Michielvsb/po2-marsrover/eindverslag.tex

\documentclass[a4paper,10pt]{article}
%\documentclass[dutch]{IEEEtran}
%\documentclass[a4paper,10pt]{scrartcl}
\usepackage{pdfpages} 
\usepackage[dutch]{babel}
\usepackage[utf8]{inputenc}
\usepackage[official]{eurosym}
\usepackage{listings}
%\usepackage{caption}
\usepackage{url}
\usepackage[nottoc, numbib]{tocbibind}
\usepackage{gensymb}
\usepackage{placeins}
\usepackage{float}
%\usepackage[style=ieee, backend=bibtex]{biblatex}
 
\title{Conceptueel schaalmodel van een autonome Marsrover}
\author{Floris Kint \and Selwin Konijn \and Evert Leeuws \and Urban Lemmens \and Jan-Uwe Lorent \and Michiel Vanschoonbeek \and Vincent Vliegen \and Ruben Verhulst}
\date{\today}

\pdfinfo{%
  /Title    (Conceptueel schaalmodel van een autonome Marsrover)
  /Author   (Team 208: Floris Kint, Selwin Konijn, Evert Leeuws, Urban Lemmens, Jan-Uwe Lorent, Michiel Vanschoonbeek, Vincent Vliegen, Ruben Verhulst)
  /Creator  ()
  /Producer ()
  /Subject  ()
  /Keywords ()
}

\begin{document}
\maketitle
\newpage
\input{inhoudstafel.tex}
\newpage
\listoffigures
\newpage
\listoftables
\newpage
\input{inleiding/sec.tex}
\input{conceptkeuze-ontwerp/sec.tex}
\input{experimenten/sec.tex}
\input{demonstratie/sec.tex}
\input{teamprestatie/sec.tex}
\input{discussie/sec.tex}
\input{besluit/sec.tex}
\input{bijlagen/sec.tex}

\bibliographystyle{IEEEtran}
\bibliography{referenties}{}

\end{document}
