Michielvsb/po2-marsrover/conceptkeuze-ontwerp/sec.tex

 
\section{Conceptkeuze en ontwerp}
De lijst met productvereisten hielp bij het vinden van het beste idee. Het ontwerp dat het best voldeed aan de vereisten, een vierwieler met een stuurmechanisme gelijkaardig aan dat van een auto, kreeg verdere uitwerking.
Hierna volgt een besluit over de combinatie van sensoren waarmee de wagen uitgerust is om de omgeving zo goed mogelijk te kunnen aftasten. Rekening houdend met de prijs bleek een afstandssensor, gemonteerd op een servomotor het meest voordelig. Verder is er een elektromotor om de wagen aan te drijven en een servomotor om het stuurmechanisme aan te drijven. 

Een preciezere beschrijving van het mechanisch en elektronisch gedeelte volgt in de volgende paragrafen.

\input{conceptkeuze-ontwerp/materialen/sec.tex}
\input{conceptkeuze-ontwerp/mechanisch/sec.tex}
\input{conceptkeuze-ontwerp/elektronisch/sec.tex}
\input{conceptkeuze-ontwerp/ai/sec.tex}
