Michielvsb/po2-marsrover/conceptkeuze-ontwerp/materialen/sec.tex

\subsection{Materialen}
In het bouwen van de wagen zijn verschillende materialen en onderdelen gebruikt. De belangrijkste zijn hieronder terug te vinden.

De bodemplaat van de wagen is van MDF (hout) en uitgesneden met behulp van een lasercutter. Het sturingsmechanisme is gebouwd uit Lego Technics en de  wielen hebben een doorsnede van 60 mm. Voor de overbrenging zijn er zes tandwielen van 26 mm en twee kleinere tandwielen van 5,2 mm doorsneden.
Een MM28 motor zorgt ervoor dat de wagen kan rijden. 

De wagen verzamelt zijn informatie met behulp van een IR-afstandssensor en een Arduino Uno-controller verwerkt deze informatie dan. Twee servomotors bewegen het sturingsmechanisme en de IR-sensor. Het geheel is verbonden met behulp van kabels die op een Printed Circuit Board gesoldeerd zijn. Een battery pack levert stroom aan de elektrische componenten. 

De volledige materiaallijst is opgenomen in Bijlage~\ref{bijlage:materiaallijst}.
