Michielvsb/po2-marsrover/bijlagen/materiaallijst/sec.tex

\subsection{Materiaallijst}
\label{bijlage:materiaallijst}
\FloatBarrier
\begin{center}
\begin{table}
\begin{tabular}{| p{3cm} | l | p{3cm} | p{2cm} | p{2cm}|}
\hline
& \textbf{Aantal} & \textbf{Component\-nummer / product\-informatie} & 
\textbf{Prijs Per Stuk (\euro)} & \textbf{Totaal (\euro)}\\\hline
\emph{Mechanisch gedeelte} &  &  &  & \\\hline
MDF (hout) & 1 & 60cm*30cm*3mm & 1 & 1\\\hline
Onderdelen Lego* &  & Geschatte kostprijs: \euro15 & 0 & 0\\\hline
Duct Tape &  &  & 0 & 0\\\hline
Schroefogen & 9 &  & 0.12 & 1.08\\\hline
Bouwpakket & 2 &  & 2.6 & 5.2\\\hline
Tandwiel 50/10 & 10 & 841027 & 0.1 & 1\\\hline
Tandwiel 30/10 & 10 & 841016 & 0.085 & 0.85\\\hline
Zeskantmoeren & 20 & M3 &  & 0\\\hline
Bouten & 30 & 3Mx10mm & 0.08 & 2.4\\\hline
Rondellen & 80 &  & 0.03 & 2.4\\\hline
Draadstang & 1 & M3 x 1000 & 2.09 & 2.09\\\hline
\emph{Elektronica} &  &  &  & \\\hline
Arduino & 1 &  & 0 & 0\\\hline
Relais & 1 & RTE24005AP & 3 & 3\\\hline
Mosfet & 2 & IRF3707ZPBF &  & 0\\\hline
Weerstand & 2 & 10k & 0.05 & 0.1\\\hline
Servomotor & 2 & T010050 & 11 & 22\\\hline
Elektromotor & 2 & MM28 & 4 & 8\\\hline
Afstandsensor & 1 & GP2D120XJ00F & 16 & 16\\\hline
LED & 1 & L-934 GD & 0.1 & 0.1\\\hline
Administratie en verzendkosten &  &  &  & 1\\\hline
 &  &  & \textbf{Totaal} & \textbf{66.22}\\\hline
 \multicolumn{5}{l}{*De LEGO-onderdelen werden niet aangekocht maar in bruikleen 
van een teamlid gebruikt.}\\
 
\end{tabular}
\caption[Materiaallijst]{Materiaallijst}
\label{table:materiaallijst}
\end{table}
\begin{table}
 \begin{tabular}{|l|l|l|l|}
 \hline
\textbf{LEGO Technic} &  &  & \\\hline
 &  &  & \\\hline
\multicolumn{4}{|p{10cm}|}{De LEGO Technic-onderdelen staan hieronder vermeld 
met een zelfgedefinieerde naam. Verdere informatie is terug te vinden met behulp 
van het componentnummer.} \\\hline
\textbf{Naam} & \textbf{Componentnummer} &  & \textbf{Aantal} \\\hline
 &  &  & \\\hline
voorwielas & 4263624 &  & 2\\\hline
bevestiging voorwielas & 4225033 &  & 2\\\hline
velg & 4496707 &  & 4\\\hline
band & 4235705 &  & 4\\\hline
 &  &  & \\\hline
blokje 3 gaten & 4153718 &  & 3\\\hline
blokje 15 gaten & 4163147 &  & 2\\\hline
blokje  3 gaten boven-boven-zij & 4173970 &  & 2\\\hline
blokje 3 gaten boven-zij-boven & 4128598 &  & 4\\\hline
blokje 2 gaten dun & 4186678 &  & 4\\\hline
 &  &  & \\\hline
L-vormig blokje 5x3 & 4143154 &  & 2\\\hline
L-vormig blokje 4x2 & 4141270 &  & 2\\\hline
L-vormig blokje 3x3 dun & 4114741 &  & 6\\\hline
 &  &  & \\\hline
kruisstaaf 16 mm & 4142865 &  & 2\\\hline
kruisstaaf 24 mm & 4211815 &  & 4\\\hline
kruisstaaf 56 mm & 4211805 &  & 4\\\hline
kruisstaaf 96 mm & 370826 &  & 4\\\hline
 &  &  & \\\hline
connectiepin rond 16 mm & 4121715 &  & 12\\\hline
connectiepin rond-kruis 16 mm & 4206482 &  & 2\\\hline
 &  &  & \\\hline
cilindrisch tussenstuk 4 mm & 4211573 &  & 4\\\hline
cilindrisch tussenstuk 8 mm & 4211622 &  & 10\\\hline
cilindrisch tussenstuk 16 mm & 4211543 &  & 1\\\hline
 &  &  & \\\hline
 &  & \textbf{Totaal: }& \textbf{80}\\\hline

 \end{tabular}
\caption{LEGO Technic-onderdelen}
\label{table:lego-technic-onderdelen}
\end{table}

\end{center}
\FloatBarrier
