Michielvsb/po2-marsrover/bijlagen/programma-code/sec.tex

\subsection{Programmacode}
\label{bijlage:programma-code}

\lstinputlisting[language=C, caption=basis\_sketch.ino]{bijlagen/programma-code/basis_sketch/basis_sketch.ino}
\lstinputlisting[language=C, caption=DistanceSensor.h]{bijlagen/programma-code/basis_sketch/DistanceSensor.h}
\lstinputlisting[language=C, caption=DistanceSensor.ino]{bijlagen/programma-code/basis_sketch/DistanceSensor.ino}
\lstinputlisting[language=C, caption=DrivingManager.h]{bijlagen/programma-code/basis_sketch/DrivingManager.h}
\lstinputlisting[language=C, caption=DrivingManager.ino]{bijlagen/programma-code/basis_sketch/DrivingManager.ino}
\lstinputlisting[language=C, caption=LedOutput.h]{bijlagen/programma-code/basis_sketch/LedOutput.h}
\lstinputlisting[language=C, caption=LedOutput.ino]{bijlagen/programma-code/basis_sketch/LedOutput.ino}
\lstinputlisting[language=C, caption=Motor.h]{bijlagen/programma-code/basis_sketch/Motor.h}
\lstinputlisting[language=C, caption=Motor.ino]{bijlagen/programma-code/basis_sketch/Motor.ino}
\lstinputlisting[language=C, caption=MusicPlayer.h]{bijlagen/programma-code/basis_sketch/MusicPlayer.h}
\lstinputlisting[language=C, caption=MusicPlayer.ino]{bijlagen/programma-code/basis_sketch/MusicPlayer.ino}
\lstinputlisting[language=C, caption=MyServo.h]{bijlagen/programma-code/basis_sketch/MyServo.h}
\lstinputlisting[language=C, caption=MyServo.ino]{bijlagen/programma-code/basis_sketch/MyServo.ino}
\lstinputlisting[language=C, caption=PushButton.h]{bijlagen/programma-code/basis_sketch/PushButton.h}
\lstinputlisting[language=C, caption=PushButton.ino]{bijlagen/programma-code/basis_sketch/PushButton.ino}
