Michielvsb/po2-marsrover/bijlagen/gebruikte-symbolen/sec.tex

\subsection{Lijst van gebruikte symbolen}
\label{bijlage:gebruikte-symbolen}
$m$ = massa\\
$g$ = valversnelling\\
$G$ = universele gravitatieconstante ($6.6754*10^{-11} \frac{m^3}{s^2*kg}$)\\
$v$ = snelheid\\
$x$ = verplaatsing\\
$a$ = versnelling\\
$\mu$ = rolweerstandsco\"effici\"ent\\ 
$Cd$ = luchtweerstandsco\"effici\"ent\\
$F_{motor}$ = voortdrijvende kracht door motor\\
$F_{rol}$ = rolweerstand\\
$F_{lucht}$ = luchtweerstand\\
$\theta$ = hoek\\
$A$ = oppervlakte\\
$\rho$ = dichtheid\\
$\eta$ = overbrenging\\
$\omega$ = hoeksnelheid\\
$R$ = straal\\
$T$ = koppel van motor\\
