Michielvsb/po2-marsrover/eindverslag.pdf

# Conceptueel schaalmodel van een autonome Marsrover

Floris Kint | Selwin Konijn | Evert Leeuws
Urban Lemmens | Jan-Uwe Lorent
Michiel Vanschoonbeek | Vincent Vliegen | Ruben Verhulst

16 mei 2014

1

## Inhoudsopgave

Lijst van figuren | 3
Lijst van tabellen | 4
1 Inleiding | 5
2 Conceptkeuze en ontwerp | 5
3 Experimenten | 9
4 Resultaten demonstratie | 10
5 Teameffici¨entie en deadlines | 10
6 Discussie | 11
7 Besluit | 11
8 Bijlagen | 11
9 Referenties | 61

2

## Lijst van figuren

1 | 3D-model van het wagentje gemaakt met Solid Edge | | 7
2 | Vrij-lichaamsdiagram luchtweerstand | | 34
3 | Technische tekening van de wagen | | 42
4 | Technische tekening van het stuur | | 43
5 | Elektrische schakeling | | 44
6 | Poster | | 60

3

## Lijst van tabellen

4

## 1 Inleiding

Bij het verkennen van de ruimte en andere hemellichamen zijn er verschillende factoren die tot problemen kunnen leiden. De grote afstand is daar ´e´en van. Op een andere planeet zou een verkenningsrover hierdoor een vertraging van inkomende en uitgaande signalen ondervinden. Deze vertraging zou tot problemen kunnen leiden bij het besturen van de rover. Dit probleem kan opgelost worden door de rover voor een deel autonoom te maken. Deze kan dan zelf een veilige weg vinden en obstakels ontwijken. Er zijn ook andere zaken waarbij een autonome wagen nuttig kan zijn. Google is bijvoorbeeld bezig met het bouwen van een wagen die zonder bestuurder de weg op kan. Deze zou dan vanzelf de beste en veiligste weg naar de bestemming zoeken. Doordat een computer veel sneller kan reageren dan mensen zou dit het aantal verkeersongelukken drastisch kunnen verlagen. Dit zou ook tot minder files en benzineverbruik leiden omdat computers veel effici¨enter kunnen rijden dan mensen. [1]
De marsrover Curiosity is een voorbeeld van zo’n autonome rover. Deze bezit 17 camera’s waarmee hij zijn omgeving kan aftasten. Aan de hand van de verzamelde informatie kan de Curiosity een veilig pad over het marsoppervlak vinden. Dit spaart tijd uit voor de bestuurders van de rover op aarde.[2, 3] De specifieke opdracht bestaat uit het ontwerpen van een wagentje dat autonoom een vooraf onbekend parcours moet afleggen. Het parcours is maximaal 12 m lang, minimaal 40 cm breed en de afbakenende muren zijn 18 cm hoog. De af te leggen weg bestaat uit rechte hoeken en er zijn geen plaatsen waarin het wagentje vast kan komen te zitten (er zijn geen doodlopende zijwegen). Het wagentje moet het parcours zo snel mogelijk afleggen en bij het bereiken van de finish een visueel of auditief signaal geven. De totaalprijs van het ontwerp mag maximaal e80 bedragen.
Met behulp van een afstandssensor verzamelt de wagen informatie over de omgeving. De Arduino Uno-controller ontvangt de metingen. Daarna verwerkt deze de informatie en zendt dan weer aan de hand van computercode signalen uit naar de motoren en het stuurmechanisme zodat de wagen op de juiste baan blijft. Op deze manier kan de wagen autonoom een onbekend parcours afleggen, zoals de opdracht vereist.
In dit verslag zal in het eerste deel de definitieve conceptkeuze, met name het mechanische en elektronische ontwerp aan bod komen. Ook de materiaalkeuze voor de rover komt hier aan bod. De volgende sectie “Experimenten” bevat de ontwerpberekeningen en de uitgevoerde experimenten. Deze zijn ondersteund met informatie uit bijlages A en B. Daarna volgt een bespreking van de resultaten van de demonstratie. Als laatste wordt het behalen van de deadlines besproken. Doorheen het verslag zullen er enkele belangrijke bevindingen aan bod komen. De theoretische optimale overbrengingsverhouding kan bijvoorbeeld niet behaald worden. De luchtweerstand is pas merkbaar bij hoge snelheden en kan dus verwaarloosd worden bij het rijden op het parcours.

## 2 Conceptkeuze en ontwerp

De lijst met productvereisten hielp bij het vinden van het beste idee. Het ontwerp dat het best voldeed aan de vereisten, een vierwieler met een stuurmechanisme gelijkaardig aan dat van een auto, kreeg verdere uitwerking. Hierna

5

volgt een besluit over de combinatie van sensoren waarmee de wagen uitgerust is om de omgeving zo goed mogelijk te kunnen aftasten. Rekening houdend met de prijs bleek een afstandssensor, gemonteerd op een servomotor het meest voordelig. Verder is er een elektromotor om de wagen aan te drijven en een servomotor om het stuurmechanisme aan te drijven.
Een preciezere beschrijving van het mechanisch en elektronisch gedeelte volgt in de volgende paragrafen.

### 2.1 Materialen

In het bouwen van de wagen zijn verschillende materialen en onderdelen gebruikt. De belangrijkste zijn hieronder terug te vinden.
De bodemplaat van de wagen is van MDF hout en uitgesneden met behulp van een lasercutter. Het sturingsmechanisme is gebouwd uit Lego Technics en de wielen hebben een doorsnede van 60 mm. Voor de overbrenging zijn er zes tandwielen van 26 mm en twee kleinere tandwielen van 5,2 mm doorsneden. Een MM28 motor zorgt ervoor dat de wagen kan rijden.
De wagen verzamelt zijn informatie met behulp van een IR-afstandssensor en een Arduino Uno-controller verwerkt deze informatie dan. Twee servomotors bewegen het sturingsmechanisme en de IR-sensor. Het geheel is verbonden met behulp van kabels die op een Printed Circuit Board gesoldeerd zijn. Een battery pack levert stroom aan de elektrische componenten.
De volledige materiaallijst is opgenomen in Bijlage 8.10.

### 2.2 Mechanisch

Het wagentje is een vierwieler. Een model van de wagen bevindt zich in Figuur 1. Aan de voorkant is langs beide kanten een rechthoek uitgesneden. Deze uitsnijdingen zorgen ervoor dat de wielen genoeg plaats hebben om te kunnen draaien. Achteraan is een as waarop beide achterwielen gefixeerd zijn. Op de achteras is een elektromotor (MM28) aangesloten die zorgt voor de aandrijving van de wagen. De motor staat via een reeks van tandwielen in verbinding met de achteras. Deze tandwielen zorgen voor de nodige overbrenging naar de wielen. Deze overbrenging heeft een verhouding van 1 op 125, waarbij de achteras 125 keer trager draait dan de motor. De wagen remt door het uitschakelen van de motor. De rolweerstand en de wrijving veroorzaakt door de overbrenging, is voldoende om de wagen op tijd te laten stoppen. De voorwielen staan elk op een aparte as. De twee assen zijn verbonden met een stuurmechanisme waardoor de voorwielen altijd parallel staan ten opzichte van elkaar. De wielen kunnen wel schuin komen te staan ten opzichte van de middenlijn. Hierdoor kan de auto gemakkelijk bochten nemen. De assen bewegen onder impuls van een servomotor. Deze servomotor drijft het sturingsmechanisme aan waardoor de wielen een hoek van ten hoogste 45 graden kunnen maken ten opzichte van de middenlijn. De afstandssensor is bovenop het sturingsmechanisme aangebracht, helemaal vooraan de wagen.
De bodemplaat wordt schuin gemonteerd op beide assen en ligt hoger aan de achterkant. De plaat staat schuin omdat de motor en overbrenging aan de onderkant gemonteerd zijn. Hierdoor is er genoeg plaats over aan de bovenkant voor de elektronica en kunnen de tandwielen de draden niet beschadigen. Op de bovenkant van de bodemplaat komt de Arduino, de batterij en het Printed

6


Figuur 1: 3D-model van het wagentje gemaakt met Solid Edge.

Circuit Board (PCB). Het gewicht wordt hierbij zo centraal mogelijk geplaatst, zodat het stuurmechanisme nog genoeg grip heeft om de koers van de wagen te wijzigen, zonder daarbij te veel weerstand te veroorzaken voor de servomotor. Bij een te hoge weerstand zou de servomotor de wielen niet op tijd kunnen draaien en zou de wagen de muur raken.
Het voordeel aan dit ontwerp is dat de stabiliteit, snelheid en wendbaarheid geoptimaliseerd worden.

### 2.3 Elektronisch

De aansturing van de Mars Rover gebeurt via een Arduino Uno-controller. Deze microcontroller kan een analoog of digitaal signaal versturen naar het elektronisch gedeelte van het wagentje. Voor het realiseren van een autonome rover staan verschillende sensoren en actuatoren op de wagen gemonteerd die onderling met elkaar communiceren via de controller.
Het meten van de omgeving gebeurt via een optische afstandssensor, gemonteerd op een servomotor. Die heeft een bereik van 0◦

tot 180◦
en richt de
afstandssensor beurtelings vooruit en zijdelings. Op die manier kan de omgeving in drie richtingen in kaart gebracht worden. De configuratie van een servomotor met een afstandssensor is goedkoper dan drie afstandssensoren die in de te verkennen richtingen gefixeerd worden, maar heeft als nadeel dat de afstand tot obstakels niet continu in elke richting bepaald kan worden.
De afstandssensor bestaat uit een infraroodzender en een lichtsensor. De sensor meet het tijdsverschil tussen het verzenden van het licht en het moment wanneer de lichtsensor een gereflecteerd signaal terug ontvangt en bepaalt zo de afstand tot een obstakel.[4] De keuze viel op deze sensor omdat die de meest bruikbare informatie geeft van alle sensors. Met een lichtsensor is het lastig werken zonder lichtbronnen en als er gewerkt wordt met geleiding (de aluminiumstrip) bestaat de output enkel uit ‘ja of neen’, zonder verdere informatie over de plaats van de rover in zijn omgeving.

7

Aan het einde van het parcours zal de afstandssensor zowel vooraan, links als rechts het signaal krijgen dat er een obstakel in de weg staat. Dan zal er een LED-licht knipperen.
Om de rover aan te drijven wordt een MM28 DC-motor gebruikt. Het inbrengen van een elektronische schakelaar, namelijk een relais, realiseert de ompoling van de motor. Zo is de rover in staat om in beide richtingen te kunnen rijden. Ook de snelheid kan gevarieerd worden door het gebruik van een MOSFET-transistor zodat de rover in de bochten zijn snelheid kan vertragen.
Voor de besturing van de rover wordt ´e´en servomotor gebruikt die aangesloten is op een stuurmechanisme. Aan de hand van een stuursignaal, gebaseerd op pulsbreedtes, kan de servomotor in de gewenste hoek geplaatst worden. Aangezien er geen grote stromen door de Arduino-controller mogen lopen (maximaal grootteorde van enkele tientallen mA), moeten de signalen en de eigenlijke stroomtoevoer voor de motoren gesplitst worden. Daarom wordt gebruik gemaakt van een MOSFET-transistor. Dit soort transistor sluit de stroomkring met de batterij en de motoren van zodra de drempelspanning overschreden wordt. Deze drempelspanning wordt verkregen tussen gate- en sourcepin van de MOSFET.[5]

### 2.4 AI

De aansturende software op de Arduinocontroller laat de radarsensor afwisselend links, vooruit en rechts de afstand meten. Afhankelijk van de gemeten waarden stuurt de software het wagentje bij. Van zodra voor de afstandssensor vooruit een muur opmerkt, stopt het wagentje. Afhankelijk van de gemeten waarden links en rechts, weet de software aan welke kant het volgende deel van het traject zich bevindt. Indien zich aan beide kanten een muur bevindt, is de rover op de bestemming aangekomen en knippert een LED. Wanneer er voor het wagentje geen muur staat en de waarden links en rechts indiceren dat het wagentje zich tussen twee muren bevindt, maar dat de ene muur dichterbij is dan de andere, stuurt de software de baan van de wagen bij.
De software bestaat uit verschillende klassen die abstractie maken van de hardwarespecifieke commando’s om de sensoren in te lezen en de actoren aan te sturen. Zo is er een MyServo-, LedOutput-, Motor-, DistanceSensor-, MusicPlayer en PushButtonklasse. Deze laatste twee werden niet gebruikt in het uiteindelijke ontwerp, maar het programmeren van de skeletten gebeurde reeds in een eerste fase van het project.
De DrivingManagerklasse is de centrale unit van waaruit de wagen aangestuurd wordt. Deze klasse neemt de beslissingen zoals hierboven beschreven. DrivingManager kan de objecten manipuleren door middel van duidelijke commando’s, zonder details over de onderliggende commando’s. De methode setMotorSpeed in de klasse Motor regelt zo bijvoorbeeld de snelheid van de motoren en de staat van de relais, zodat ook achteruit gereden kan worden.
Om het testen van de aparte sensoren en actoren te vergemakkelijken, staan er ook enkele demo’s in de DrivingManager-klasse. Deze zijn bedoeld om de specifieke elementen te testen. De methode radarDemo roteert bijvoorbeeld de servo waarop de afstandssensor gemonteerd is en de ingelezen waarden van de afstandssensor worden dan (geconverteerd naar centimeter) doorgestuurd via

8

de Serial Monitor¹
. Op die manier kan dit onderdeel gemakkelijker onderzocht worden op problemen als het aangesloten is aan de Arduino IDE² .
De volledige code bevindt zich in Bijlage 8.9.

## 3 Experimenten

### 3.1 Rolweerstand

Het kennen van de rolweerstand is belangrijk bij het berekenen van de snelheid van de wagen en voor het verlies van elektrische energie in warmtevorming. De rolweerstand wordt berekend door de omzetting van potenti¨ele energie naar kinetische energie te bestuderen. Met behulp van de wet van behoud van energie kan de verloren energie ten gevolge van de wrijving berekend worden aan de hand van het tweede postulaat van Newton. Verdere uitleg en uitgebreide berekeningen staan in Bijlage 8.2.
Uit experimenten blijkt dat de gebruikte wielen een wrijvingsco¨effici¨ent van 0.06 hebben.

### 3.2 Luchtweerstand

De luchtweerstand is naast de rolweerstand een andere oorzaak van energieverlies. Deze afwijking moet in rekening gebracht worden bij het opstellen van de bewegingsvergelijking van de wagen.
De wagen wordt losgelaten van een bepaalde hoogte op een hellend vlak. De wagen wordt hierbij gefilmd van bovenaf. Met behulp van video-analyse kan de theoretisch opgestelde baan vergeleken worden met de experimenteel afgelegde baan. De theoretische baan houdt alle tot dan toe gekende parameters in rekening. Door een variabele luchtweerstandco¨efficient in te voeren kan de beste benadering tot de praktische baan gevonden worden.
De luchtweerstand blijkt minder belangrijk dan de rolweerstand. Enkel op hogere snelheden, die de wagen niet bereikt, speelt de luchtweerstand een significante rol.

### 3.3 Koppeloverdracht

De ideale koppeloverdracht moet berekend worden om te leren hoe de elektromotoren zo effici¨ent mogelijk gebruikt kunnen worden. Een slecht gekozen overdrachtsverhouding zou leiden tot energieverspilling. Verdere uitleg en uitgebreide berekeningen staan in Bijlage 8.4.
De optimale overbrenging blijkt 1/18 te bedragen. Deze is echter in praktijk niet realiseerbaar, omdat de achterwielen van de wagen dan weinig grip zouden hebben op de ondergrond. Daarom wordt gewerkt met een overbrenging van 1/125.

1
Interface om data naar de aangesloten computer te versturen.
2
Integrated Development Environment (ge¨ıntegreerde ontwikkelomgeving).

9

### 3.4 Snelheidsmeting

### 3.5 Animatiefilmpje

Een lineaire vergelijking bleek een erg goede benadering voor de bewegingsvergelijking van het wagentje (zie Bijlage 8.6). Het animatiefilmpje simuleert de beweging van het karretje dan ook alsof het een constante snelheid heeft gedurende het volledige parcours.
De Maplefile bevindt zich in Bijlage 8.6. Met behulp van de voorgedefinieerde plot3d-functies (polygonplot3d), plot Maple het parcours en het wagentje in een opeenvolging van frames. Verschillende zelfgedefinieerde procedures structureren het plotten van een frame door het onder te verdelen in enkele deeltaken. Zo zijn er de procedures plot_wagentje en plot_wall_part die voor een gegeven positie (en rotatie voor het wagentje), de nodige matrixbewerkingen uitvoeren en vervolgens het gevraagde object plotten. Het parcours is gedefinieerd als een opeenvolging van punten. De muren en het wagentje worden opengetrokken op basis van hun coordinaten in het vlak. De bovenkant van de muren en het karretje zijn loodrechte translaties van het grondvlak. Telkens worden de overeenkomstige zijden als rechthoek geplot, zodat het model gesloten is. De respectievelijke middens tussen de achterwielen en de voorwielen bevinden zich altijd op de lijn van het parcours. Met behulp van eenvoudige goniometrie wordt het karretje gedurende het rijden geroteerd zodat altijd aan deze voorwaarde voldaan is en de constante snelheid over de lijn behouden blijft. Deze vorm van rotatie is slechts een model en komt niet overeen met de bochten die het werkelijke ontwerp maakt. De werkelijke rover stuurt enkel met de voorwielen en kan niet in rechte hoeken draaien, wat in het animatiefilmpje wel gebeurt.

## 4 Resultaten demonstratie

## 5 Teameffici¨entie en deadlines

De oorspronkelijke planning bleek te optimistisch. Vooral op het vlak van de bouw van het wagentje en het elektrisch schema bleek veel meer tijd nodig. Bij de bouw van het mechanisch gedeelte waren er enkele problemen die naar boven kwamen. Zo bleek het karretje te groot om effici¨ent te navigeren. Een tweede versie van het karretje had een kleiner grondvlak, maar omwille van de keuze voor twee motoren, moest de plaat nog steeds relatief groot zijn. Verder heeft het erg lang geduurd vooraleer de elektrische schakeling klaar was. Het gevolg hiervan was dat de programmacode slechts op het allerlaatste moment getest kon worden met de hardware. Hierdoor was het wagentje niet klaar om de demonstratie te doen.
Een meer planmatige aanpak zou deze problemen beter kunnen voorkomen. Ook het strikter naleven van de deadlines had veel kunnen helpen.
Door het laattijdig afwerken van het mechanisch en het elektronisch gedeelte, zijn ook de experimenten naar latere tijdstippen verplaatst. De aanpak van de experimenten was meer planmatig. De planning van de experimenten en het opstellen van de Maplebestanden gebeurde in afwachting van het mechanisch gedeelte. Ook het maken van het animatiefilmpje gebeurde in die periode.

10

## 6 Discussie

## 7 Besluit

## 8 Bijlagen

### 8.1 Lijst van gebruikte symbolen

m = massa
g = valversnelling
G = universele gravitatieconstante (6.6754 ∗ 10⁻¹¹ m³
s

2∗kg )
v = snelheid
x = verplaatsing
a = versnelling
µ = rolweerstandsco¨effici¨ent
Cd = luchtweerstandsco¨effici¨ent
Fmotor = voortdrijvende kracht door motor Frol = rolweerstand
Flucht = luchtweerstand
θ = hoek
A = oppervlakte
ρ = dichtheid
η = overbrenging
ω = hoeksnelheid
R = straal
T = koppel van motor

11

### 8.2 Berekening rolweerstand

### 8.2.1 De rolweerstand op Aarde

Een belangrijke eigenschap van de rover is de rolweerstand. Dit heeft een grote invloed in de effici¨entie van het rijden. Met een grote rolweerstand komt de wagen veel sneller tot stilstand dan bij een kleine rolweerstand. Het bepalen van de rolweerstand is niet moeilijk. Met behulp van een schuine plank is het mogelijk het verband te zoeken tussen de hoogte van waarop de wagen is losgelaten en de afstand die de wagen heeft afgelegd nadat het van de plank reed.
Doordat de snelheid van het wagentje tijdens het experiment zeer beperkt blijft, heeft de luchtweerstand slechts een verwaarloosbare invloed. Het is dan ook toegestaan die te negeren bij dit experiment.
Wanneer de wagen boven op de plank staat, heeft het door de zwaartekracht een zekere potenti¨ele energie.
Epot = m ∗ g ∗ h | (1)

Wanneer de wagen naar beneden rolt, zet het die potenti¨ele energie om in kinetische energie.

Ekin =

m ∗ v

2
2

(2)

Aan de onderkant van de helling is alles omgezet in kinetische energie. De snelheid v is nu te berekenen door de vorige 2 formules aan elkaar gelijk te stellen. Voor het berekenen van deze snelheid wordt de wrijving met de grond tijdens het rijden op de helling verwaarloosd. Dit is echter een redelijke veronderstelling doordat de wrijving zeer klein is ten opzichte van de zwaartekracht.
Terwijl de wagen verder rolt, verliest het deze energie door de wrijving met de grond. Uit de bewegingsvergelijking hieronder kan de versnelling a berekend worden. 3

x =

1
2

∗

−v
a

2
+ v ∗
−v
a
(3)

Terwijl de wagen verder rolt, spelen er drie krachten op in. Dit zijn de zwaartekracht, de normaalkracht en de wrijvingskracht. Aangezien de wagen horizontaal rijdt, heeft alleen de wrijvingskracht invloed op de versnelling. Met behulp van het 2de Postulaat van Newton kan de rolweerstand bepaald worden.

Frol = Fres = m ∗ a | (4)

Ten slotte wordt de wrijvingsco¨effici¨ent µ bepaald met behulp van de definitie van de rolweerstand.
µ =

Frol

Fnormaal

=

Frol
m ∗ g

(5)

Om de onnauwkeurigheid van meetresultaten zo goed mogelijk te beperken, werd dit experiment zes keren herhaald. De definitieve wrijvingsco¨effici¨ent is het gemiddelde van de zes bekomen co¨effici¨enten. deze waarde bedraagt:

µ = 0.067

3Deze vergelijking werd afgeleid door team 419 in P&O 1 opdracht 3

12

### 8.2.2 De rolweerstand op Mars

Het vinden van de rolweerstand op Mars gebeurt op een zeer gelijkaardige manier als het vinden van de rolweerstand op Aarde. Het enige verschil is de gravitatieconstante g. Om de gravitatieconstante van Mars te berekenen, bestaat de volgende formule.

g =

G ∗ mMars

(rMars)

2

(6)

Wanneer deze nieuwe gravitatieconstante ingevuld wordt in de vorige vergelijkingen, wordt de nieuwe rolweerstand

Frol = 0.12N

13

(4)

(2)

(8)

(7)

(10)

(12)

(6)

(11)

(3)

>

(5)

(1)

(9)

(13)

restart;

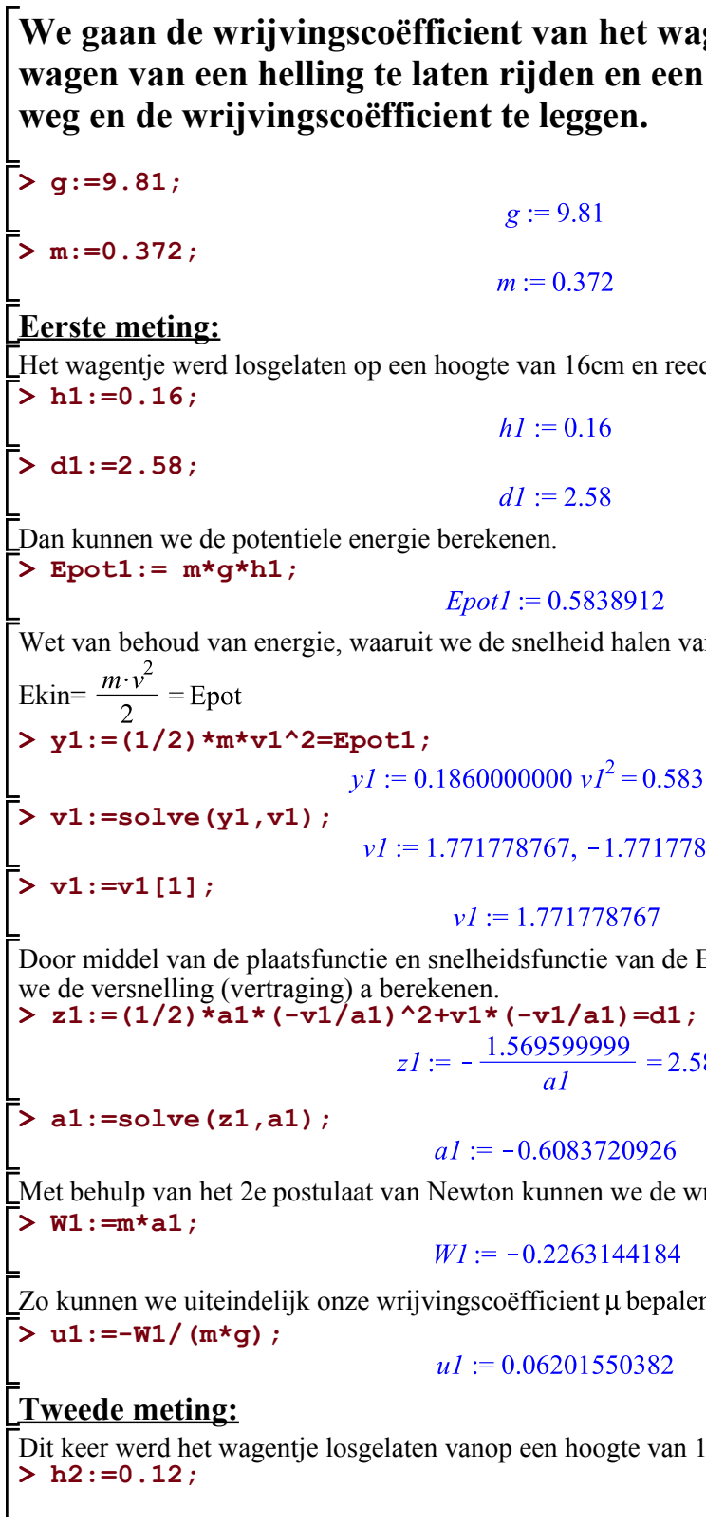
[picture p2: figure]
Eerste meting:; Epot1:= m*g*h1;; Ekin=; y1:=(1/2)*m*v1^2=Epot1;; v1:=solve(y1,v1);; a1:=solve(z1,a1);; Tweede meting:

## We gaan de wrijvingscoëfficient van het wagentje berekenen door de wagen van een helling te laten rijden en een verband tussen de afgelegde

weg en de wrijvingscoëfficient te leggen.

Het wagentje werd losgelaten op een hoogte van 16cm en reed 258 cm ver.

Dan kunnen we de potentiele energie berekenen.

Wet van behoud van energie, waaruit we de snelheid halen van het autootje onderaan de plank.

Door middel van de plaatsfunctie en snelheidsfunctie van de EVRB die het autootje uitvoert, kunnen we de versnelling (vertraging) a berekenen.

Met behulp van het 2e postulaat van Newton kunnen we de wrijvingskracht bepalen.

Zo kunnen we uiteindelijk onze wrijvingscoëfficient

Dit keer werd het wagentje losgelaten vanop een hoogte van 12cm en reed het 185 cm ver.

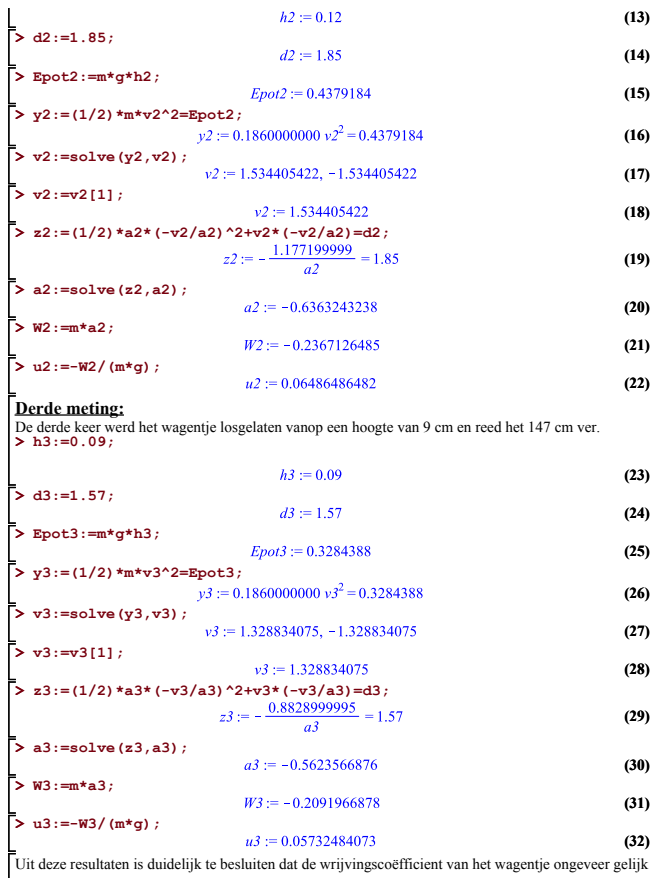
[picture p3: page 15]
Epot2:=m*g*h2;; y2:=(1/2)*m*v2^2=Epot2;; v2:=solve(y2,v2);; a2:=solve(z2,a2);; Epot3:=m*g*h3;; y3:=(1/2)*m*v3^2=Epot3;; v3:=solve(y3,v3);; a3:=solve(z3,a3);

Derde meting:
De derde keer werd het wagentje losgelaten vanop een hoogte van 9 cm en reed het 147 cm ver.

Uit deze resultaten is duidelijk te besluiten dat de wrijvingscoëfficient van het wagentje ongeveer gelijk

is aan 0.06.

### 8.3 Berekening luchtweerstand

Een ander belangrijke eigenschap van de rover is de luchtweerstand. Deze heeft maar weinig invloed bij lage snelheden, maar begint zeker mee te tellen zodra de snelheid stijgt. Het bepalen van de luchtweerstand gebeurt in twee stappen. Eerst wordt met behulp van een krachtenevenwicht (zie Figuur 2) een differentiaalvergelijking opgesteld en opgelost. Hiermee wordt de theoretische baan van de wagen berekend. Dit staat wel nog altijd in functie van een onbekende Cd, de luchtweerstandsco¨effici¨ent.
Vervolgens wordt met behulp van video-analyse de feitelijke baan opgemeten. De werkelijke baan en de theoretische baan worden met alkaar vergeleken. Ten slotte wordt er een kleinste-kwadratische oplossing gezocht in voor Cd.

### 8.3.1 Theoretische baan

17

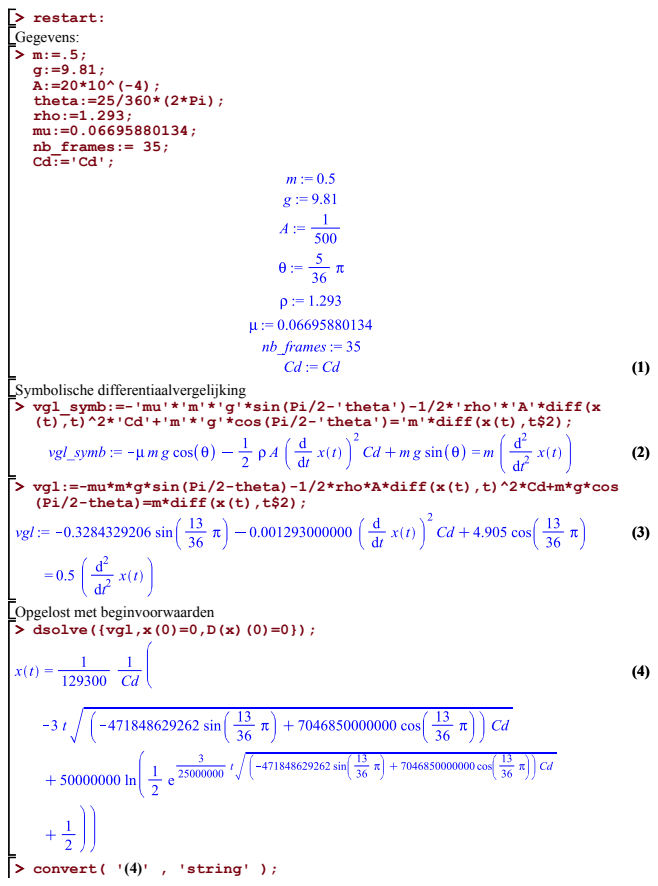
[picture p4: page 18]
restart: Gegevens: m:=.5; g:=9.81; A:=20*10^(-4); theta:=25/360*(2*Pi); rho:=1.293; mu:=0.06695880134; nb_frames:= 35; Cd:='Cd';; convert( '(4)' , 'string' );

Symbolische differentiaalvergelijking
vgl_symb:=-'mu'*'m'*'g'*sin(Pi/2-'theta')-1/2*'rho'*'A'*diff(x
(t),t)^2*'Cd'+'m'*'g'*cos(Pi/2-'theta')='m'*diff(x(t),t$2);

vgl:=-mu*m*g*sin(Pi/2-theta)-1/2*rho*A*diff(x(t),t)^2*Cd+m*g*cos
(Pi/2-theta)=m*diff(x(t),t$2);

Opgelost met beginvoorwaarden
dsolve({vgl,x(0)=0,D(x)(0)=0});

"x(t) = 1/129300*(-3*t*((-471848629262*sin(13/36*Pi)C7046850000000*cos(13/36*Pi))*Cd)^ (5) (1/2)C50000000*ln(1/2*exp(3/25000000*t*((-471848629262*sin(13/36*Pi) C7046850000000*cos(13/36*Pi))*Cd)^(1/2))C1/2))/Cd"

Deze vergelijking wordt in Excel ingevuld om de luchtweerstandscoëfficiënt Cd te vinden.

Wanneer de rover naar beneden rolt, werken er vier krachten op in, namelijk de zwaartekracht, de normaalkracht, de rolweerstand en de luchtweerstand. Voor het opstellen van de bewegingsvergelijking wordt de x-as evenwijdig met de helling gelegd. Zo is de versnelling alleen maar in de x-richting en moeten alleen maar de x-componenten van de krachten beschouwd worden.

Frol = −µ ∗ m ∗ g ∗ cos(θ) | (7)

Flucht = −

1
2

∗ ρlucht ∗ A ∗ Cd ∗

dx

dt 2
(8)
Fzwaartekracht = m ∗ g ∗ sin(θ) | (9)

De bewegingsvergelijking wordt dus

Fzwaartekracht − F rol − Flucht = m ∗

d

2x
dt²

2
(10)

Deze vergelijking kan opgelost worden in functie van Cd.

### 8.3.2 Feitelijke baan

20

# Luchtweerstandexperiment Hoek: 25°

# Afgelegde horizontale afstand per frame (0,03s)

TIJD | Test 1 (blokjes 5cm) | (m) | Theoretisch (m)
0 | 0 | 0 | 0
0,033333 | 0 | 0 | 0,001971999
0,066667 | 0 | 0 | 0,007881583
0,1 | 0 | 0 | 0,01770959
0,133333 | 0 | 0 | 0,031424363
0,166667 | 0 | 0 | 0,048982149
0,2 | 0,25 | 0,0125 | 0,070327656
0,233333 | 0,75 | 0,0375 | 0,095394728
0,266667 | 1,75 | 0,0875 | 0,124107153
0,3 | 2,5 | 0,125 | 0,156379547
0,333333 | 3 | 0,15 | 0,192118324
0,366667 | 3,5 | 0,175 | 0,231222711
0,4 | 4,5 | 0,225 | 0,273585798
0,433333 | 5 | 0,25 | 0,319095589
0,466667 | 6 | 0,3 | 0,367636054
0,5 | 7 | 0,35 | 0,419088143
0,533333 | 8,25 | 0,4125 | 0,473330766
0,566667 | 9,25 | 0,4625 | 0,53024171
0,6 | 10,5 | 0,525 | 0,589698495
0,633333 | 11,5 | 0,575 | 0,651579163
0,666667 | 13 | 0,65 | 0,715762979
0,7 | 14,25 | 0,7125 | 0,782131063
0,733333 | 15,75 | 0,7875 | 0,850566935
0,766667 | 17,25 | 0,8625 | 0,920956983
0,8 | 18,75 | 0,9375 | 0,993190861
0,833333 | 20,5 | 1,025 | 1,0671618
0,866667 | 22,25 | 1,1125 | 1,142766869
0,9 | 24 | 1,2 | 1,21990716
0,933333 | 26 | 1,3 | 1,298487922
0,966667 | 28 | 1,4 | 1,378418645
1 | 30 | 1,5 | 1,459613093
1,033333 | 31,5 | 1,575 | 1,541989304
1,066667 | 33,5 | 1,675 | 1,625469552
1,1 | 35,5 | 1,775 | 1,709980284

kwadratische verschilwaarden | luchtweerstands coëfficient
0 | cd | 159,7217
3,88878E-06
6,21193E-05
0,00031363
0,000987491
0,002399251
0,003344038
0,0033518
0,001340084
0,000984676
0,001773953
0,003160993
0,00236058
0,0047742
0,004574636
0,004773172
0,003700382
0,004588939
0,004185895
0,005864368
0,004324769
0,004848485
0,003977438
0,003417219
0,003101472
0,001777617
0,000916083
0,000396295
2,28638E-06
0,000465755
0,001631102
0,001089706
0,002453265
0,004227563

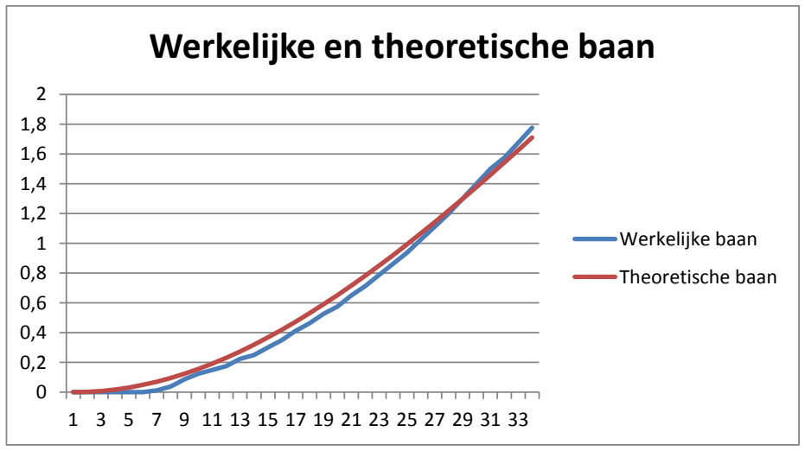
[picture p5: figure]
Werkelijke en theoretische baan; Werkelijke baan; Theoretische baan

### Kleinste kwadratische oplossing:

0,085173153

1 3 5 7 9 11 13 15 17 19 21 23 25 27 29 31 33

# Luchtweerstandexperiment Hoek: 25°

# Afgelegde horizontale afstand per frame (0,03s)

TIJD | Test 2 (blokjes 5cm) | (m) | Theoretisch (m)
0 | 0 | 0 | 0
0,033333 | 0 | 0 | 0,001972
0,066667 | 0 | 0 | 0,007875
0,1 | 0 | 0 | 0,017675
0,133333 | 0 | 0 | 0,031316
0,166667 | 0 | 0 | 0,048721
0,2 | 0 | 0 | 0,069794
0,233333 | 0,5 | 0,025 | 0,094421
0,266667 | 1 | 0,05 | 0,122475
0,3 | 1,25 | 0,0625 | 0,153816
0,333333 | 1,75 | 0,0875 | 0,188293
0,366667 | 2,5 | 0,125 | 0,225751
0,4 | 3 | 0,15 | 0,266027
0,433333 | 3,75 | 0,1875 | 0,308958
0,466667 | 4,5 | 0,225 | 0,35438
0,5 | 5,25 | 0,2625 | 0,40213
0,533333 | 6 | 0,3 | 0,452048
0,566667 | 7,25 | 0,3625 | 0,503979
0,6 | 8,25 | 0,4125 | 0,557773
0,633333 | 9,5 | 0,475 | 0,613288
0,666667 | 10,5 | 0,525 | 0,670386
0,7 | 11,75 | 0,5875 | 0,728939
0,733333 | 13 | 0,65 | 0,788825
0,766667 | 14,5 | 0,725 | 0,849931
0,8 | 16 | 0,8 | 0,91215
0,833333 | 17,5 | 0,875 | 0,975385
0,866667 | 19,25 | 0,9625 | 1,039543
0,9 | 20,75 | 1,0375 | 1,104541
0,933333 | 22,25 | 1,1125 | 1,170302
0,966667 | 24,25 | 1,2125 | 1,236754
1 | 26,5 | 1,325 | 1,303832
1,033333 | 28 | 1,4 | 1,371477
1,066667 | 30 | 1,5 | 1,439634
1,1 | 32 | 1,6 | 1,508254
1,133333 | 34,25 | 1,7125 | 1,577292
1,166667 | 36,5 | 1,825 | 1,646707

# kwadratische verschilwaarden

0
3,89E-06 | luchtweerstandscoëfficient:
6,2E-05 | cd | 287,8693
0,000312
0,000981
0,002374
0,004871
0,004819
0,005253
0,008339
0,010159
0,010151
0,013462
0,014752
0,016739
0,019497
0,023119
0,020016
0,021104
0,019124
0,021137
0,020005
0,019272
0,015608
0,012578
0,010077
0,005936
0,004495
0,003341
0,000588
0,000448
0,000814
0,003644
0,008417
0,018281
0,031788

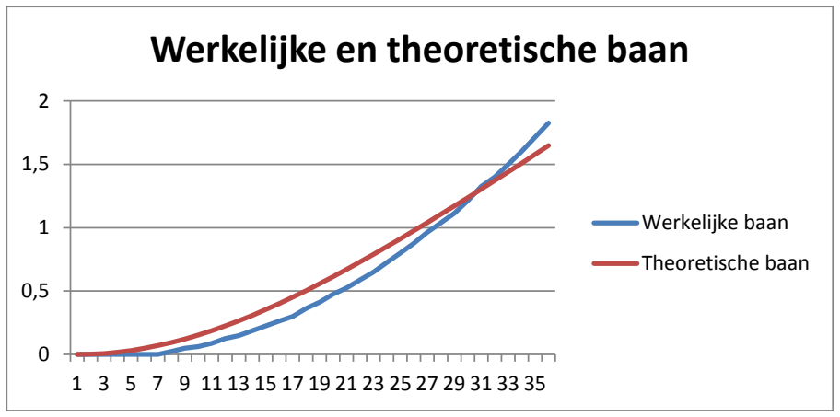
[picture p6: figure]
Werkelijke en theoretische baan; Werkelijke baan; Theoretische baan

Kleinste kwadratische oplossing 0,371567

1 3 5 7 9 11 13 15 17 19 21 23 25 27 29 31 33 35

# Luchtweerstandexperiment Hoek: 25°

# Afgelegde horizontale afstand per frame (0,03s)

TIJD | Test 3 (blokjes 5cm) | (m) | Theoretisch (m)
0 | 0 | 0 | 0
0,033333 | 0 | 0 | 0,001972
0,066667 | 0 | 0 | 0,00788
0,1 | 0 | 0 | 0,017703
0,133333 | 0 | 0 | 0,031403
0,166667 | 0 | 0 | 0,04893
0,2 | 0 | 0 | 0,07022
0,233333 | 0,25 | 0,0125 | 0,095198
0,266667 | 1 | 0,05 | 0,123776
0,3 | 1,5 | 0,075 | 0,155858
0,333333 | 2 | 0,1 | 0,191336
0,366667 | 2,75 | 0,1375 | 0,230098
0,4 | 3,5 | 0,175 | 0,272025
0,433333 | 4,5 | 0,225 | 0,31699
0,466667 | 5,25 | 0,2625 | 0,364868
0,5 | 6 | 0,3 | 0,415526
0,533333 | 7,5 | 0,375 | 0,468834
0,566667 | 8,5 | 0,425 | 0,524659
0,6 | 9,5 | 0,475 | 0,582871
0,633333 | 10,75 | 0,5375 | 0,643339
0,666667 | 12 | 0,6 | 0,705938
0,7 | 13,5 | 0,675 | 0,770543
0,733333 | 14,75 | 0,7375 | 0,837034
0,766667 | 16,25 | 0,8125 | 0,905294
0,8 | 18 | 0,9 | 0,975211
0,833333 | 19,75 | 0,9875 | 1,046679
0,866667 | 21,5 | 1,075 | 1,119594
0,9 | 23,25 | 1,1625 | 1,193859
0,933333 | 25 | 1,25 | 1,269381
0,966667 | 26,75 | 1,3375 | 1,346073
1 | 28,75 | 1,4375 | 1,423851
1,033333 | 30,75 | 1,5375 | 1,502638
1,066667 | 32,75 | 1,6375 | 1,58236
1,1 | 35 | 1,75 | 1,662948
1,133333 | 37,25 | 1,8625 | 1,744339

# Kleinste kwadratische

### 0 Luchtweerstandscoëfficiënt

3,89E-06 | cd | 185,2627
6,21E-05
0,000313
0,000986
0,002394
0,004931
0,006839
0,005443
0,006538
0,008342
0,008574
0,009414
0,008462
0,010479
0,013346
0,008805
0,009932
0,011636
0,011202
0,011223
0,009129
0,009907
0,008611
0,005657
0,003502
0,001989
0,000983
0,000376
7,35E-05
0,000186
0,001215
0,00304
0,007578
0,013962

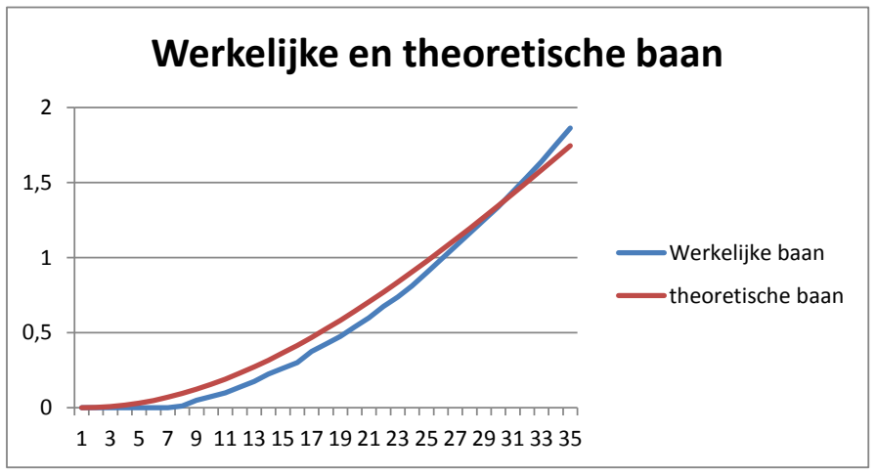
[picture p7: figure]
Werkelijke en theoretische baan; Werkelijke baan; theoretische baan

Totale kleinste kwadratische 0,205135

1 3 5 7 9 11 13 15 17 19 21 23 25 27 29 31 33 35

### 8.4 Berekening ideale overbrenging

Wanneer de rover in beweging is, werken er in totaal drie krachten op in. Deze krachten zijn de voortdrijvende kracht door de motor, de wrijvingskracht door de rolweerstand en de wrijvingskracht door de luchtweerstand. De bewegingsvergelijking is dus:

Fmotor − Frol − Flucht = m ∗ a | (11)

De wrijvingskracht door de rolweerstand wordt bepaald met behulp van de volgende vergelijking.
Frol = µ ∗ m ∗ g | (12)

De wrijvingskracht door de luchtweerstand wordt bepaald met behulp van deze vergelijking.

Flucht =

1
2

∗ ρlucht ∗ Cd ∗ A ∗ v

2
(13)

De aandrijvende kracht van de motor wordt verkregen met behulp van de volgende formule.

Fmotor =

η

Rwiel

∗

Tmax −

Tmax ∗

dx
dt

ωmax ∗ Rwiel

(14)

Door vergelijkingen 12, 13 en 14 in te vullen in vergelijking 11 kan de vergelijking volledig opgelost worden. Als beginvoorwaarden wordt de snelheid en de plaats van de wagen op tijdstip 0 gelijk gesteld aan 0. De oplossing van de vergelijking is een vergelijking met de tijd in functie van de onbekende η. Deze wordt geoptimaliseerd voor een minimale tijd om 2.5 meter af te leggen.
De optimale overbrengingsverhouding blijkt na numeriek in te vullen gelijk te zijn aan 1
18

27

# Optimale overbrengingsverhouding

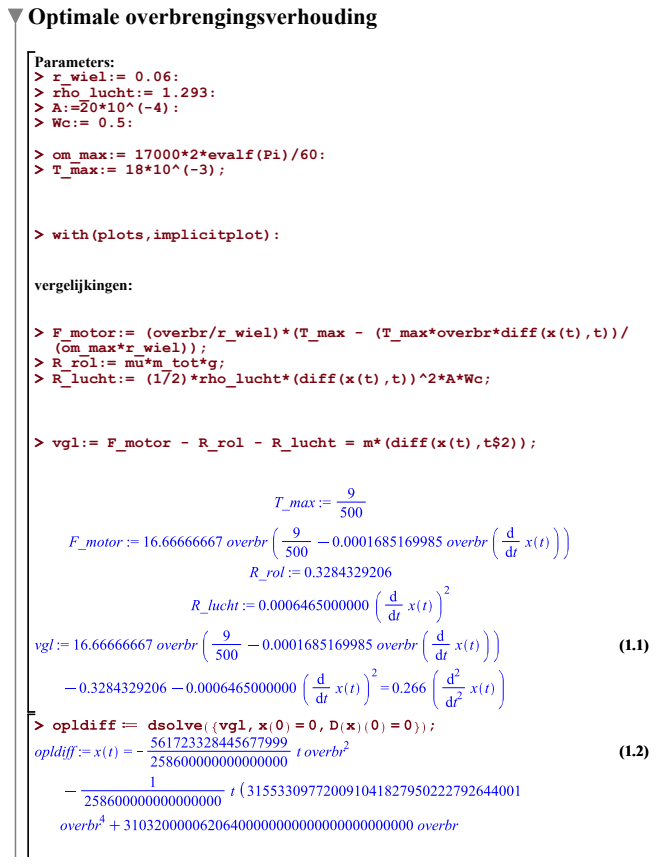
[picture p8: page 28]
Parameters: r_wiel:= 0.06: rho_lucht:= 1.293: A:=20*10^(-4): Wc:= 0.5:; om_max:= 17000*2*evalf(Pi)/60: T_max:= 18*10^(-3);; vergelijkingen:; F_motor:= (overbr/r_wiel)*(T_max - (T_max*overbr*diff(x(t),t))/ (om_max*r_wiel)); R_rol:= mu*m_tot*g; R_lucht:= (1/2)*rho_lucht*(diff(x(t),t))^2*A*Wc;; vgl:= F_motor - R_rol - R_lucht = m*(diff(x(t),t$2));

with(plots,implicitplot):

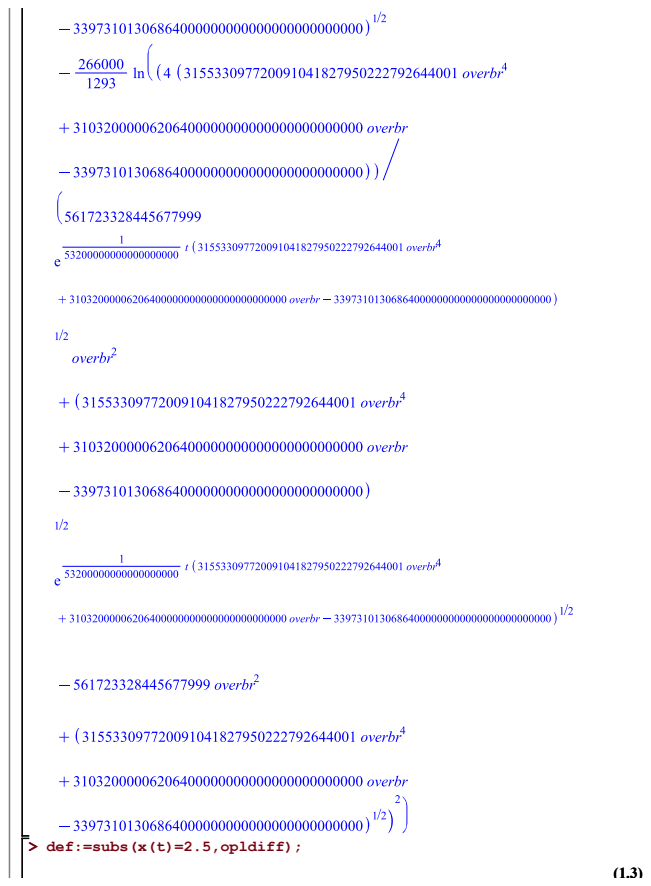
[picture p9: page 29]

def:=subs(x(t)=2.5,opldiff);

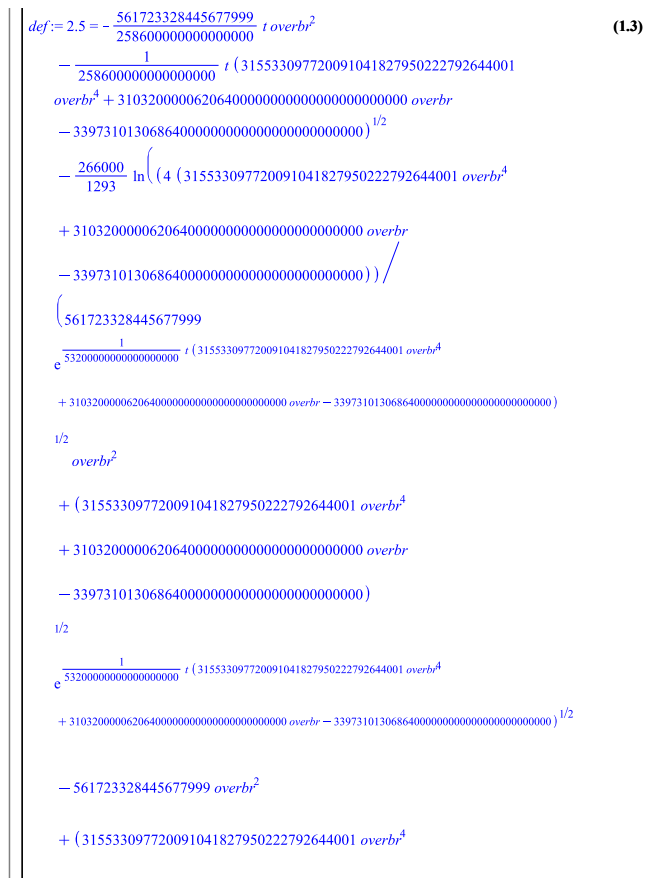
[picture p10: page 30]

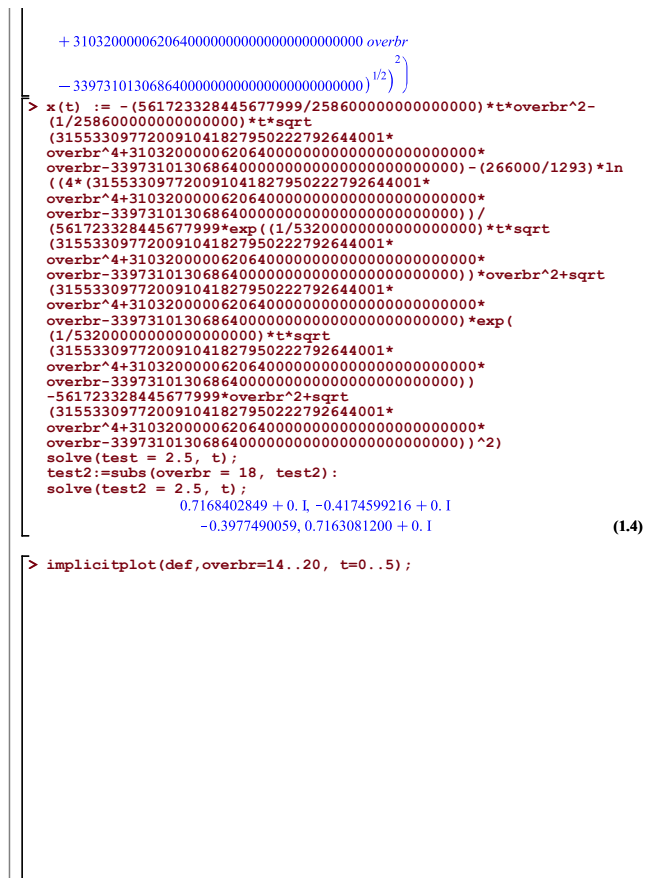
[picture p11: page 31]
x(t) := -(561723328445677999/258600000000000000)*t*overbr^2- (1/258600000000000000)*t*sqrt (315533097720091041827950222792644001* overbr^4+31032000006206400000000000000000000000* overbr-33973101306864000000000000000000000000)-(266000/1293)*ln ((4*(315533097720091041827950222792644001* overbr^4+31032000006206400000000000000000000000* overbr-33973101306864000000000000000000000000))/ (561723328445677999*exp((1/53200000000000000000)*t*sqrt (315533097720091041827950222792644001* overbr^4+3103200000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

implicitplot(def,overbr=14..20, t=0..5);

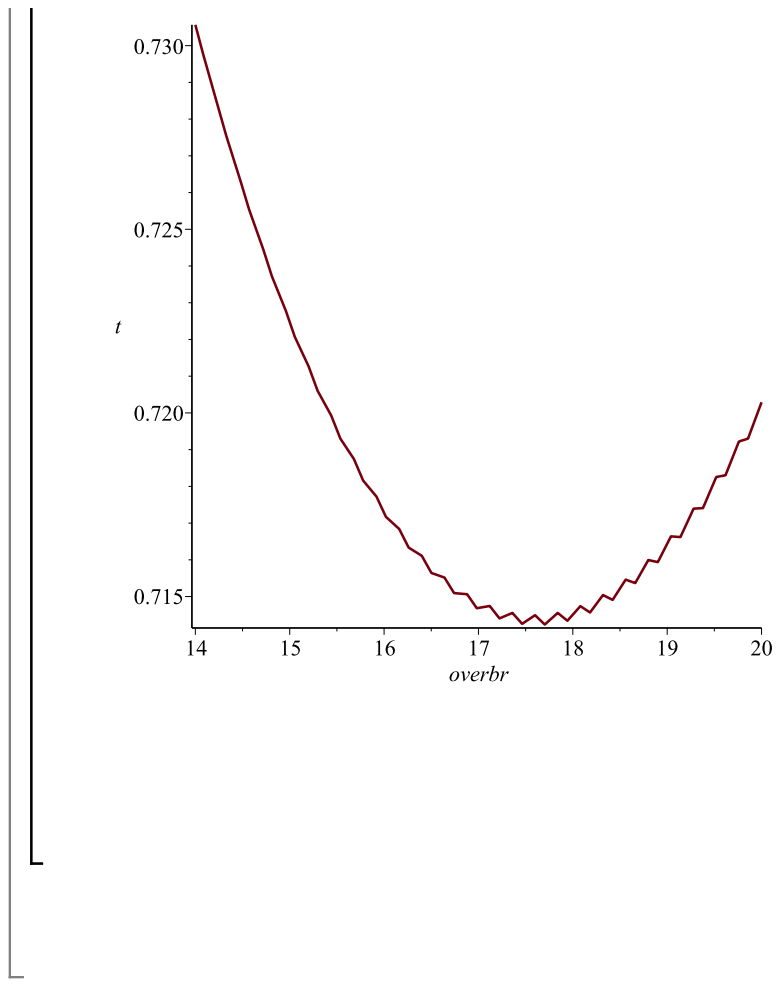
[picture p12: page 32]

### 8.5 Afstandsmeter als snelheidsmeter

In combinatie met een apparaat dat het verschil in golflengte meet, zou de afstandsmeter gebruikt kunnen worden als snelheidsmeter. Dit kan door het Doppler effect. De voorwaartse verplaatsing van de wagen zal er immers voor zorgen dat de golflengte korter wordt. Door deze verandering van golflengte kan de snelheid berekend worden.

De snelheid van elektromagnetische golven is gegeven, namelijk 299792458 m
s
De golflengte van de afstandssensor is ook gegeven.

λ =

780
10¹⁹

De frequentie van de afstandsmeter is de lichtsnelheid gedeeld door de golflengte.

f

0 =

f
1 −

vsource
c

(15)

De uitgezonden golf ondervindt al de effecten van het Doppler effect en dus wordt de nieuwe frequentie gegeven door de volgende formule.

f

0 =

f
1 −

vsource
c

(16)

De golf die de wagen bereikt is terug be¨ınvloed door het Doppler effect.

fperceived =

1 +

vsource
c
∗ f

0
(17)

Ten slotte kan met de volgende formule de snelheid van de wagen berekend worden.

vsource =

fperceived
f
∗ c − c

1 + fperceived
f

(18)

33

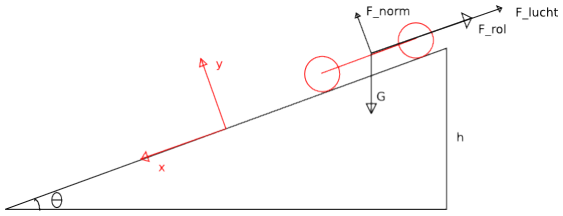
[picture p13: figure]

Figuur 2: Vrij-lichaamsdiagram luchtweerstand

### 8.6 Animatiefilmpje

34

>

>

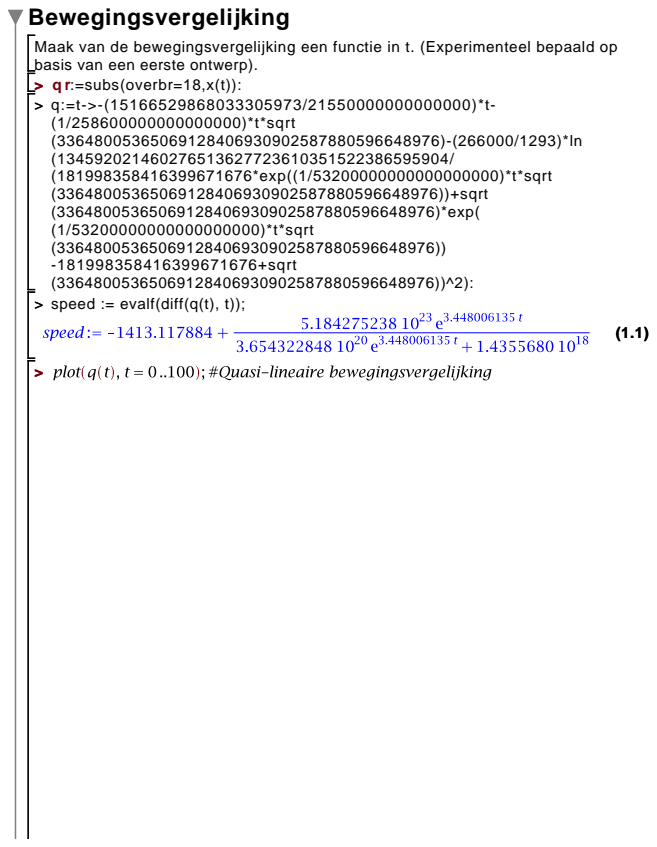
[picture p14: page 35]
Bewegingsvergelijking

Maak van de bewegingsvergelijking een functie in t. (Experimenteel bepaald op
basis van een eerste ontwerp).
qr:=subs(overbr=18,x(t)):
(1/258600000000000000)*t*sqrt
(181998358416399671676*exp((1/53200000000000000000)*t*sqrt
(33648005365069128406930902587880596648976))+sqrt
(33648005365069128406930902587880596648976)*exp(
(1/53200000000000000000)*t*sqrt
-181998358416399671676+sqrt

speed := evalf(diff(q(t), t));

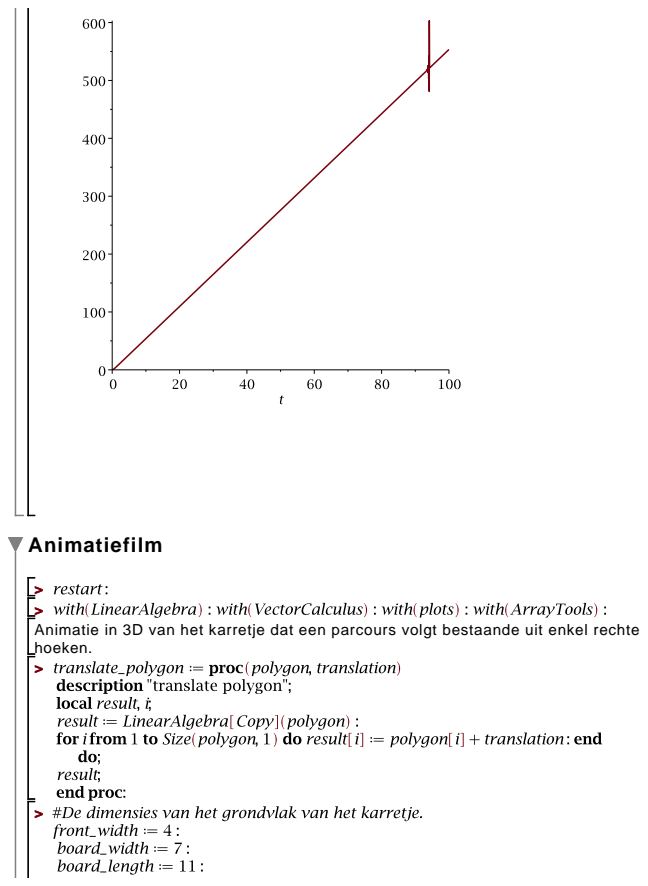
[picture p15: page 36]
Animatiefilm

Animatie in 3D van het karretje dat een parcours volgt bestaande uit enkel rechte
hoeken.

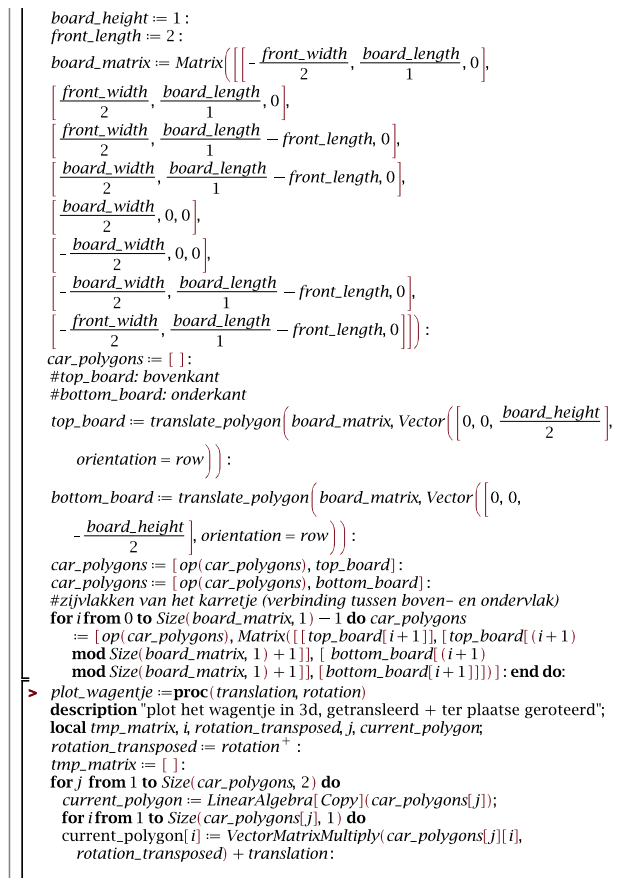
[picture p16: page 37]

>

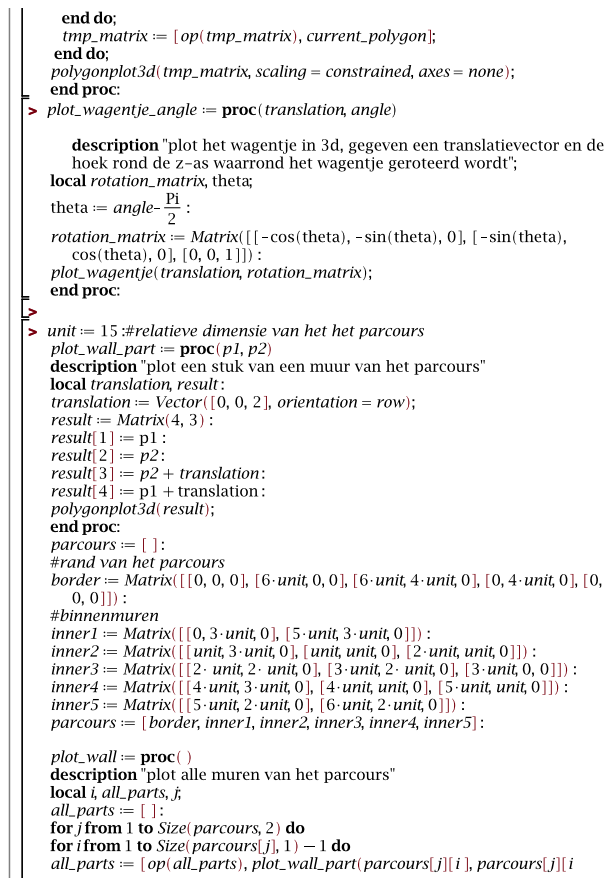
[picture p17: page 38]

>

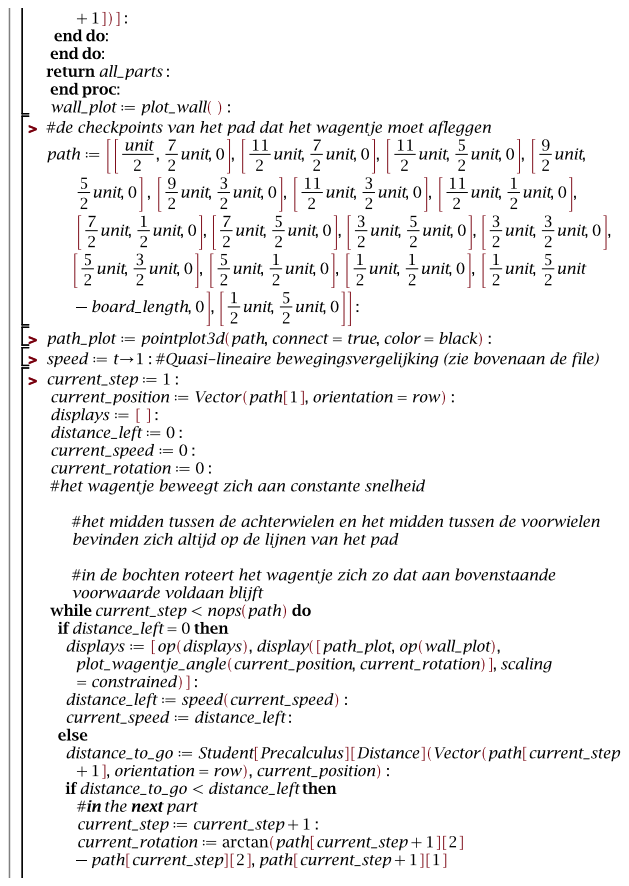
[picture p18: page 39]

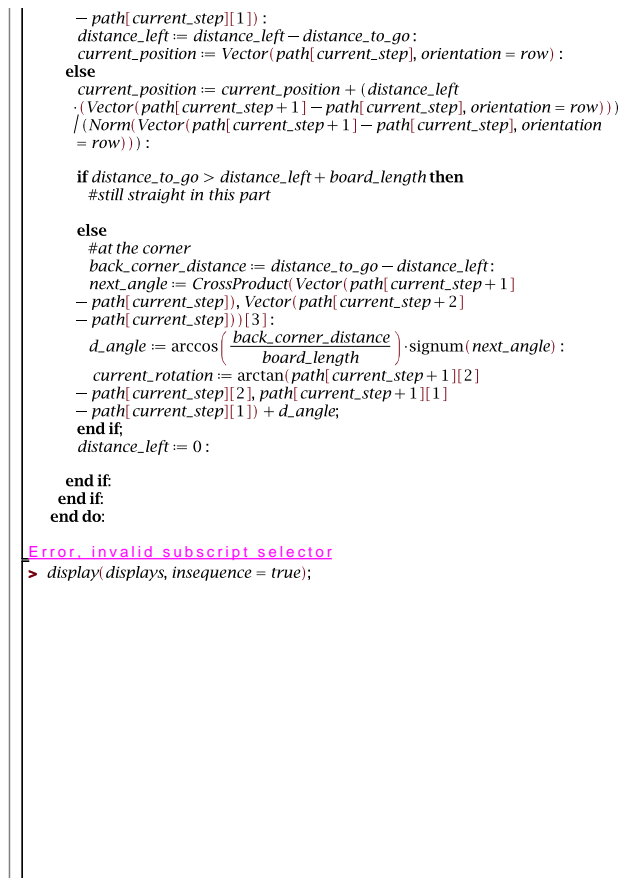
[picture p19: page 40]

Error, invalid subscript selector

>

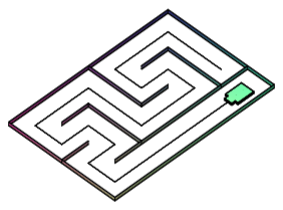
[picture p20: figure]

### 8.7 Technische tekening

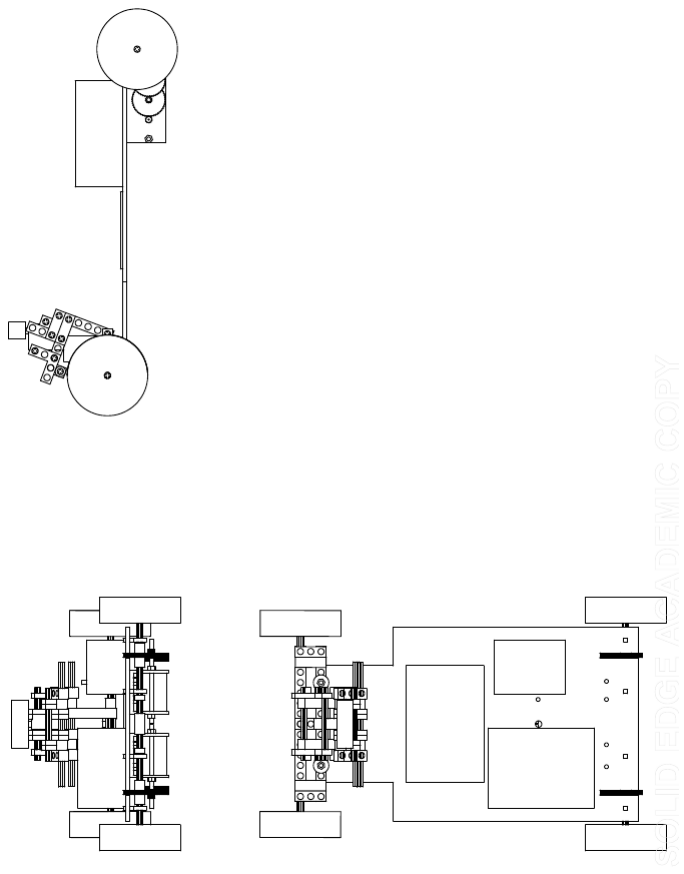
[picture p21: figure]

Figuur 3: Technische tekening van de wagen

42

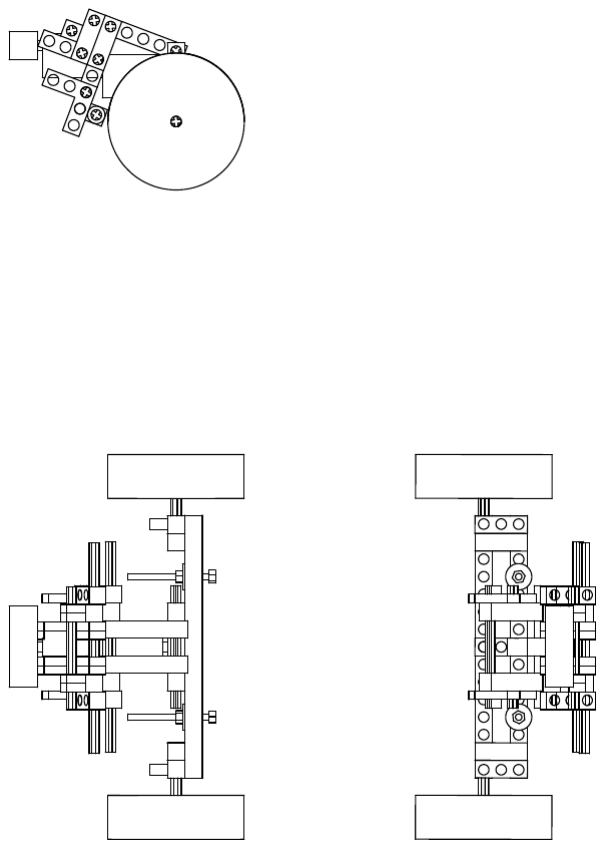
[picture p22: figure]

Figuur 4: Technische tekening van het stuur

43

### 8.8 Elektrische schakeling

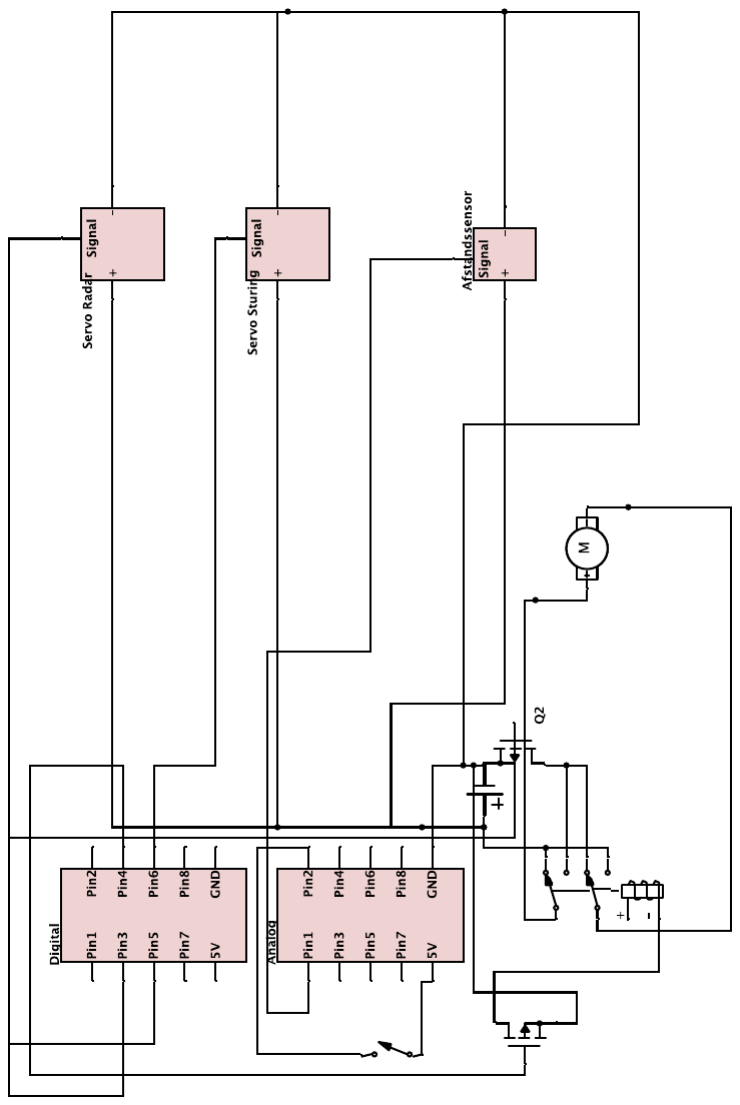
[picture p23: figure]

Figuur 5: Elektrische schakeling

44

### 8.9 Programmacode

Listing 1: basis sketch.ino #include <Servo . h>
const unsigned int DCP[ ] = {1 3 , 2 , 3 , 4 , 5 , 6 , 7 , 8 , 9 } ; const unsigned int ACP[ ] = {1 3 , A0, A1, A2, A3, A4, A5 } ; #include ”LedOutput . h”
#include ”Motor . h”

#include ”MyServo . h”

#include ” DrivingManager . h” #include ”PushButton . h”

#include ”Mu sicPlaye r . h”

#def ine FRONT 90

#def ine LEFT 0

#def ine RIGHT 180

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

#def ine RADAR SERVO DCP[ 6 ] #def ine RADAR SENSOR ACP[ 1 ] #def ine STEERING SERVO DCP[ 5 ] #def ine ELECTRO MOTOR DCP[ 3 ] #def ine RELAY DCP[ 4 ]

#def ine PUSHBUTTON ACP[ 2 ] #def ine LED DCP[ 7 ]

/∗
DIGITAL PINS (BLACK TO BROWN) 2 1
4 3
6 5
8 7
∗/

void se t up ( ) {
S e r i a l . b e gi n ( 9 6 0 0 ) ;
for ( int i = 1 ; i <= 6 ; ++i ){
pinMode (ACP[ i ] , INPUT ) ;
}
manager . se tup (RADAR SERVO, RADAR SENSOR, STEERING SERVO, ELECTRO MOTOR, RELAY) ; s t a r t b u t t o n . se tup (PUSHBUTTON) ;
e n d l e d . se t up (LED ) ;
// m u s i c pl a y e r . s e t u p (DCP [ 8 ] ) ;
manager . s t a r t ( ) ;
}

45

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

Listing 2: DistanceSensor.h #i fnd e f DISTANCESENSOR H #def ine DISTANCESENSOR H
#def ine FAR 999999

#def ine CLOSE 0

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

46

}
double Di s t a n c e S e n s o r : : g e tV ol t a g e ( ) { int v al = analogRead ( t hi s −>pin ) ; return ( ( double ) v al ) ∗ 0 . 0 0 4 9 ;
}
void Di s t a n c e S e n s o r : : debug ( ) {
S e r i a l . p r i n t l n ( t hi s −>g e tDi s t a n c e ( ) ) ; d el a y ( 1 0 0 0 ) ;
}

Listing 4: DrivingManager.h #i fnd e f DRIVINGMANAGER H #def ine DRIVINGMANAGER H
#include ”LedOutput . h”

#include ”Motor . h”

#include ”MyServo . h”

#include ” Di s t a n c e S e n s o r . h”

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

47

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

48

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

49

// t h i s −>motorDemo ( ) ; // r e t u r n ;

// e c h t e code

i f ( ! t hi s −>i s A c t i v e ( ) ) return ;

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

void DrivingManager : : s tee rin gSe rv oDem o ( ) {
| t hi s −>s t e e r i n g s e r v o . s e tA n gl e ( 3 0 ) ;
| d el a y ( 1 0 0 0 ) ;
| 50

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

void DrivingManager : : motorDemo ( ) {

//motor word t per 3 seconden omgekeerd van r i c h t i n g

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

Listing 6: LedOutput.h
#i fnd e f LEDOUTPUT H

51

#def ine LEDOUTPUT H

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

Listing 7: LedOutput.ino
#include ”LedOutput . h”

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

Listing 8: Motor.h
#i fnd e f MOTOR H

#def ine MOTOR H

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

Listing 9: Motor.ino
#include ”Motor . h”

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

52 pinMode ( t hi s −>motor pin , OUTPUT) ; pinMode ( t hi s −>r el a y pi n , OUTPUT) ;
}

void Motor : : setMotorSpeed (double m o t o r speed ){
m o t o r speed = min (max( motor speed , −1.0 ) , 1 . 0 ) ; t hi s −>m o t o r speed = m o t o r speed ;
i f ( t hi s −>m o t o r speed < 0 ){
d i g i t a lW r i t e ( t hi s −>r el a y pi n , HIGH ) ;
} e l s e {
d i g i t a lW r i t e ( t hi s −>r el a y pi n , LOW) ;
}
S e r i a l . p r i n t l n ( ( int ) ( t hi s −>m o t o r speed ∗ 2 5 5 ) ) ;
an al o gW ri te ( t hi s −>motor pin , ( int ) ( abs ( t hi s −>m o t o r speed ) ∗ 2 5 5 . 0 ) ) ; }

Listing 10: MusicPlayer.h
#i fnd e f MUSICPLAYER H

#def ine MUSICPLAYER H

c l a s s Song ;
c l a s s Mu sicPlaye r {
p u bli c :
Mu sicPlaye r ( ) ;
void l o o p ( ) ;
void se t up ( int pin ) ;
void se tS on g ( Song∗ song ) ; Song∗ getSong ( ) ;
p r o t e c t e d :
Song∗ song ;
int pin ;
} ;

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

Listing 11: MusicPlayer.ino Mu sicPlaye r : : Mu sicPlaye r ( ) {
}
void Mu sicPl aye r : : s e tup ( int pin ){ t hi s −>pin = pin ;
pinMode ( t hi s −>pin , OUTPUT) ;
}

53 void Mu sicPl aye r : : l o o p ( ) {

}
void Mu sicPl aye r : : se tS on g ( Song ∗ s ){ t hi s −>song = s ;
}
Song∗ Mu sicPlaye r : : getSong ( ) {
return t hi s −>song ;
}
Song : : Song ( int notes amount , int ∗ t one s , int ∗ n o t e d u r a ti o n s ){ t hi s −>notes amount = notes amount ;
t hi s −>t o n e s = t o n e s ;
t hi s −>n o t e d u r a ti o n s = n o t e d u r a ti o n s ;
}

Listing 12: MyServo.h
#i fnd e f MYSERVO H

#def ine MYSERVO H

c l a s s MyServo{
p u bli c :
void se t up ( int pin ) ;
void s e tA n gl e ( int a n gl e ) ; void w ai t ( ) ;
p r i v a t e :
Servo s e r v o ;
int a n gl e ;
int c onve r tAn gleT oMic r o sec ond s ( int a n gl e ) ; } ;
#end i f

Listing 13: MyServo.ino
#include ”MyServo . h”

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

void MyServo : : s e tA n gl e ( int a n gl e ){ t hi s −>a n gl e = a n gl e ;
t hi s −>s e r v o . w ri t e ( t hi s −>a n gl e ) ; }

54

Listing 14: PushButton.h
#i fnd e f PUSHBUTTON H

#def ine PUSHBUTTON H

c l a s s PushButton{
p u bli c :
void se t up ( int pin ) ; b o ol ge tV alue ( ) ;
p r i v a t e :
int pin ;
} ;
#end i f

Listing 15: PushButton.ino void PushButton : : se tup ( int pin ){ t hi s −>pin = pin ;
pinMode ( t hi s −>pin , INPUT ) ;
}

b o ol PushButton : : ge tV alue ( ) {
return analogRead ( t hi s −>pin ) < 5 0 0; }

55

### 8.10 Materiaallijst

56

| Aantal | Component-nummer / product-informatie | Prijs Per Stuk (e) | Totaal (e)

Mechanisch ge-deelte

MDF (hout) | 1 | 60cm*30cm*3mm | 1 | 1
Onderdelen Lego* | | Geschatte kostprijs: e15 | 0 | 0
Duct Tape | | | 0 | 0
Schroefogen | 9 | | 0.12 | 1.08
Bouwpakket | 2 | | 2.6 | 5.2
Tandwiel 50/10 | 10 | 841027 | 0.1 | 1
Tandwiel 30/10 | 10 | 841016 | 0.085 | 0.85
Zeskantmoeren | 20 | M3 | | 0
Bouten | 30 | 3Mx10mm | 0.08 | 2.4
Rondellen | 80 | | 0.03 | 2.4
Draadstang | 1 | M3 x 1000 | 2.09 | 2.09
Elektronica
Arduino | 1 | | 0 | 0
Relais | 1 | RTE24005AP | 3 | 3
Mosfet | 2 | IRF3707ZPBF | | 0
Weerstand | 2 | 10k | 0.05 | 0.1
Servomotor | 2 | T010050 | 11 | 22
Elektromotor | 2 | MM28 | 4 | 8
Afstandsensor | 1 | GP2D120XJ00F | 16 | 16
LED | 1 | L-934 GD | 0.1 | 0.1
Administratie en verzendkosten | | | | 1
| | | Totaal | 66.22
*De LEGO-onderdelen werden niet aangekocht maar in bruikleen van een teamlid gebruikt.

Tabel 1: Materiaallijst

57

LEGO Technic

De LEGO Technic-onderdelen staan hieronder vermeld met een zelfgedefinieerde naam. Verdere informatie is terug te vinden met
behulp van het componentnummer.
Naam | Componentnummer | Aantal
voorwielas | 4263624 | 2
bevestiging voorwielas | 4225033 | 2
velg | 4496707 | 4
band | 4235705 | 4
blokje 3 gaten | 4153718 | 3
blokje 15 gaten | 4163147 | 2
blokje 3 gaten boven-boven-zij | 4173970 | 2
blokje 3 gaten boven-zij-boven | 4128598 | 4
blokje 2 gaten dun | 4186678 | 4
L-vormig blokje 5x3 | 4143154 | 2
L-vormig blokje 4x2 | 4141270 | 2
L-vormig blokje 3x3 dun | 4114741 | 6
kruisstaaf 16 mm | 4142865 | 2
kruisstaaf 24 mm | 4211815 | 4
kruisstaaf 56 mm | 4211805 | 4
kruisstaaf 96 mm | 370826 | 4
connectiepin rond 16 mm | 4121715 | 12
connectiepin rond-kruis 16 mm | 4206482 | 2
cilindrisch tussenstuk 4 mm | 4211573 | 4
cilindrisch tussenstuk 8 mm | 4211622 | 10
cilindrisch tussenstuk 16 mm | 4211543 | 1
Totaal: | 80

Tabel 2: LEGO Technic-onderdelen

58

### 8.11 Ganttchart

59

### 8.12 Poster

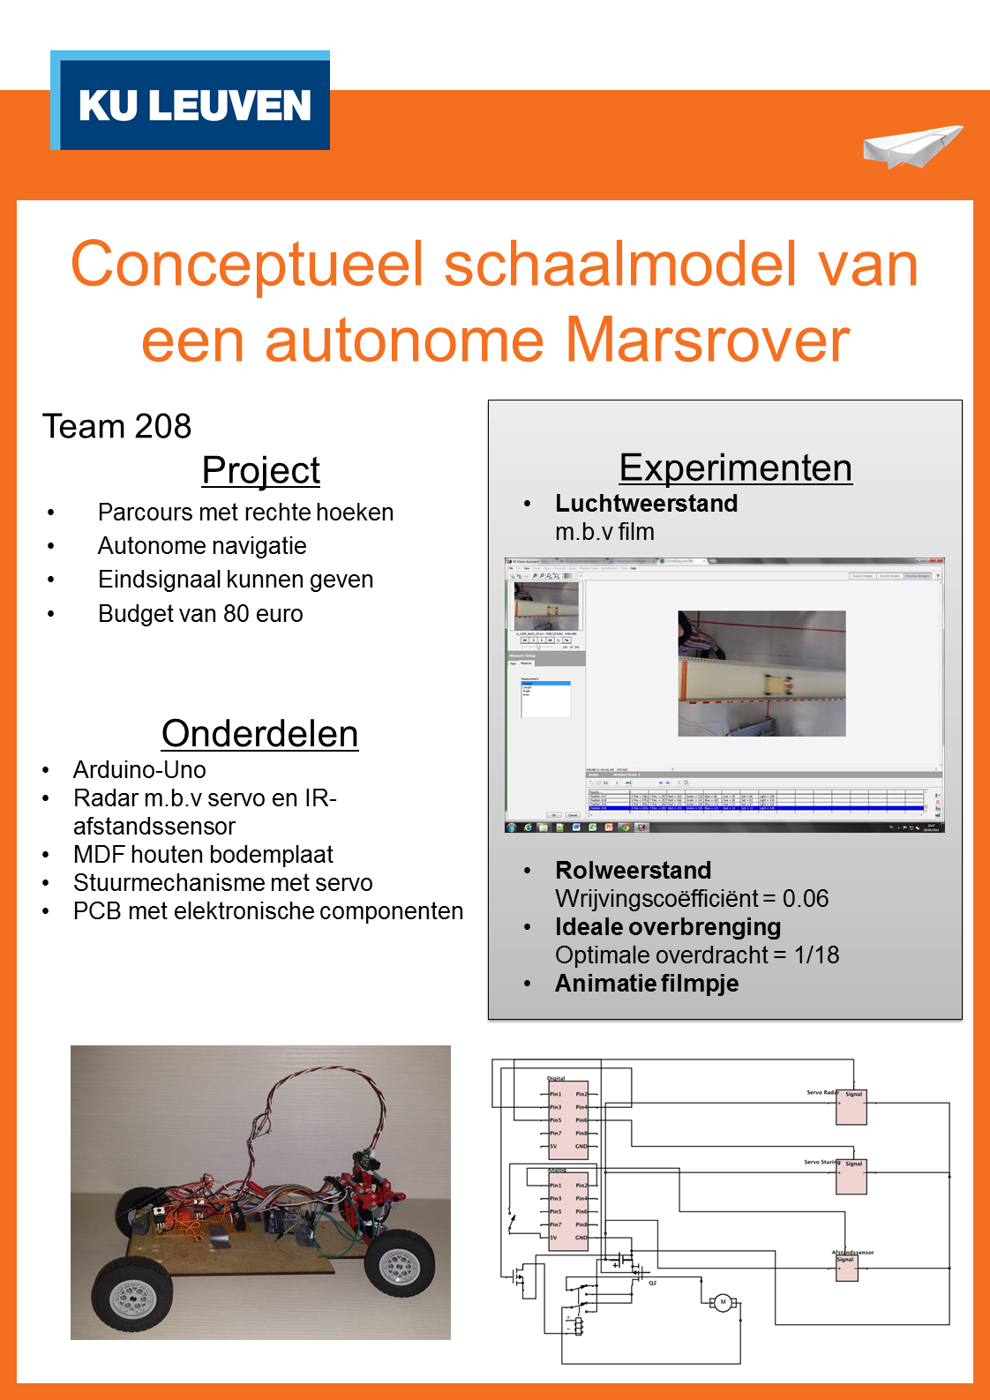
[picture p24: figure]

Figuur 6: Poster

60

## 9 Referenties

[1] E. Guizzo. (2011) How google’s self-driving car works. Raadpleging: 2014-05-01. [Online]. Available: http://spectrum.ieee.org/automaton/robotics/artificial-intelligence/how-google-self-driving-car-works
[2] NASA. Nasa curiosity. Raadpleging: 2014-04-29. [Online]. Available: http://mars.jpl.nasa.gov/msl/multimedia/interactives/learncuriosity/index-2.html
[3] ——. Nasa curiosity news. Raadpleging: 2014-04-29. [Online]. Available: http://www.jpl.nasa.gov/news/news.php?release=2013-259
[4] Sharp. GP2Y0A41SK0F datasheet. Raadpleging: 2014-05-06. [Online]. Available: http://www.sharp.co.jp/products/device/doc/opto/gp2y0a41sk e.pdf
[5] bitwizard.nl. (2012) Mosfets. Raadpleging: 2014-05-06. [Online]. Available: http://prive.bitwizard.nl/mosfets.pdf

61
