Michielvsb/po2-marsrover/bijlagen/rolweerstand/wrijvingscoefficient.pdf

(4)

(2)

(8)

(7)

(10)

(12)

(6)

(11)

(3)

>

(5)

(1)

(9)

(13)

restart;

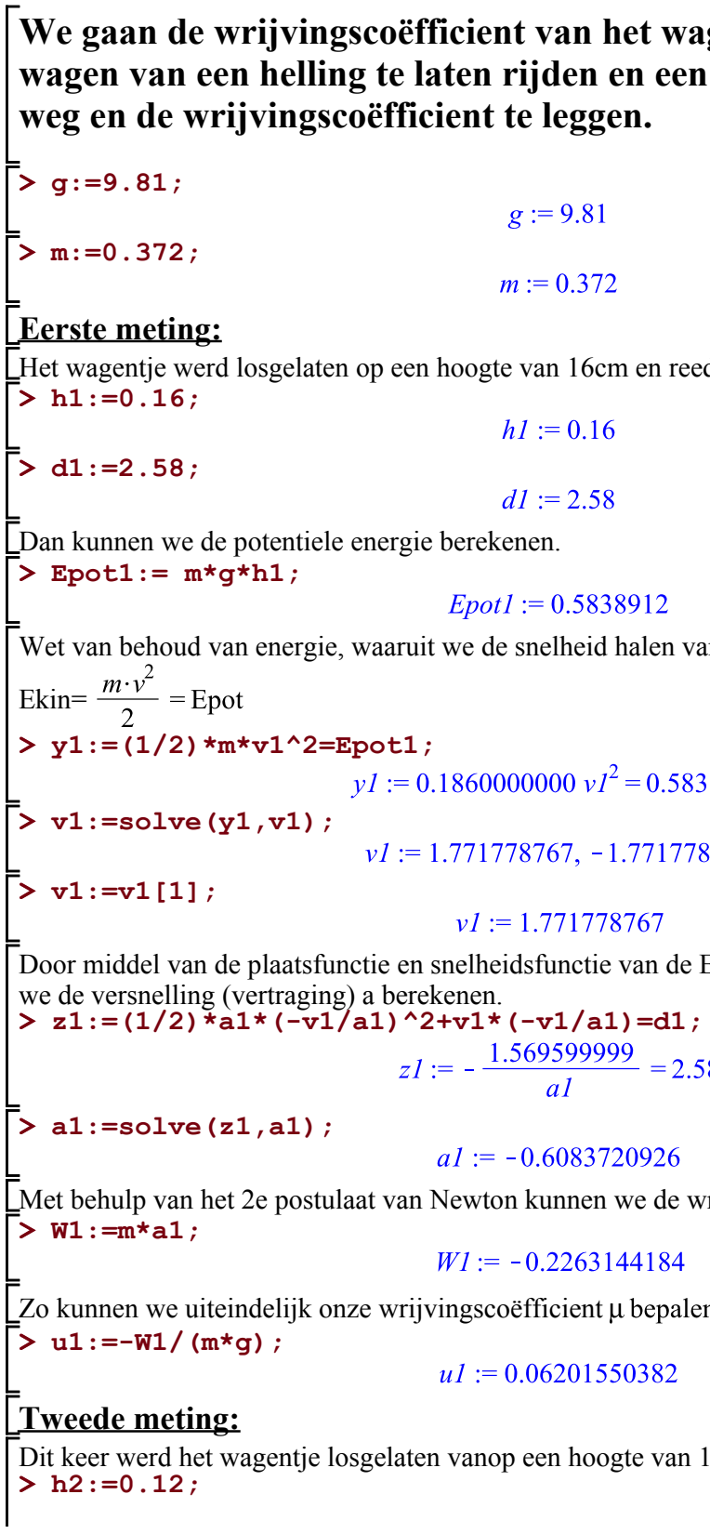
[picture p25: figure]
Eerste meting:; Epot1:= m*g*h1;; Ekin=; y1:=(1/2)*m*v1^2=Epot1;; v1:=solve(y1,v1);; a1:=solve(z1,a1);; Tweede meting:

## We gaan de wrijvingscoëfficient van het wagentje berekenen door de wagen van een helling te laten rijden en een verband tussen de afgelegde

weg en de wrijvingscoëfficient te leggen.

Het wagentje werd losgelaten op een hoogte van 16cm en reed 258 cm ver.

Dan kunnen we de potentiele energie berekenen.

Wet van behoud van energie, waaruit we de snelheid halen van het autootje onderaan de plank.

Door middel van de plaatsfunctie en snelheidsfunctie van de EVRB die het autootje uitvoert, kunnen we de versnelling (vertraging) a berekenen.

Met behulp van het 2e postulaat van Newton kunnen we de wrijvingskracht bepalen.

Zo kunnen we uiteindelijk onze wrijvingscoëfficient

Dit keer werd het wagentje losgelaten vanop een hoogte van 12cm en reed het 185 cm ver.

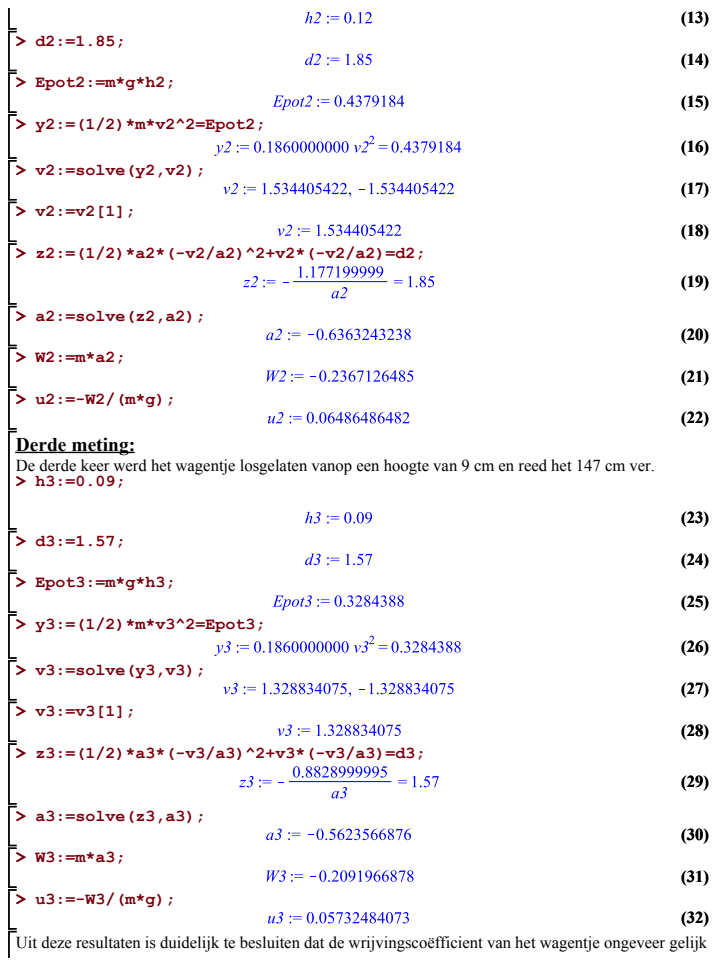
[picture p26: page 2]
Epot2:=m*g*h2;; y2:=(1/2)*m*v2^2=Epot2;; v2:=solve(y2,v2);; a2:=solve(z2,a2);; Epot3:=m*g*h3;; y3:=(1/2)*m*v3^2=Epot3;; v3:=solve(y3,v3);; a3:=solve(z3,a3);

Derde meting:
De derde keer werd het wagentje losgelaten vanop een hoogte van 9 cm en reed het 147 cm ver.

Uit deze resultaten is duidelijk te besluiten dat de wrijvingscoëfficient van het wagentje ongeveer gelijk

is aan 0.06.
