Michielvsb/po2-marsrover/bijlagen/poster/sec.tex

\subsection{Poster}
\label{bijlage:poster}

\begin{figure}[H]
\center
 
 \caption{Poster}
 \label{image:poster}
\end{figure}

\FloatBarrier
