Michielvsb/po2-marsrover/bijlagen/luchtweerstand/sec.tex

\subsection{Berekening luchtweerstand}
\label{bijlage:luchtweerstand}
Een ander belangrijke eigenschap van de rover is de luchtweerstand. Deze heeft maar weinig invloed bij lage snelheden, maar begint zeker mee te tellen zodra de snelheid stijgt. Het bepalen van de luchtweerstand gebeurt in twee stappen.\\
Eerst wordt met behulp van een krachtenevenwicht (zie Figuur~\ref{image:luchtweerstand}) een differentiaalvergelijking opgesteld en opgelost. Hiermee wordt de theoretische baan van de wagen berekend. Dit staat wel nog altijd in functie van een onbekende $Cd$, de luchtweerstandsco\"effici\"ent.\\
Vervolgens wordt met behulp van video-analyse de feitelijke baan opgemeten. De werkelijke baan en de theoretische baan worden met alkaar vergeleken. Ten slotte wordt er een kleinste-kwadratische oplossing gezocht in voor $Cd$.\\
\begin{figure}[here]

\caption{Vrij-lichaamsdiagram luchtweerstand}
\label{image:luchtweerstand}
\end{figure}
\subsubsection{Theoretische baan}
%Maple file theoretische baan
\includepdf[pages={-}]{bijlagen/luchtweerstand/luchtweerstand-theoretisch.pdf}
Wanneer de rover naar beneden rolt, werken er vier krachten op in, namelijk de zwaartekracht, de normaalkracht, de rolweerstand en de luchtweerstand. Voor het opstellen van de bewegingsvergelijking wordt de x-as evenwijdig met de helling gelegd. Zo is de versnelling alleen maar in de x-richting en moeten alleen maar de x-componenten van de krachten beschouwd worden.
\begin{equation} \label{eq:rolweerstand}
F_{rol}=-\mu*m*g*cos(\theta)
\end{equation}
\begin{equation} \label{eq:luchtweerstand}
F_{lucht}=-\frac{1}{2}*\rho_{lucht}*A*Cd*\left(\frac{dx}{dt}\right)^2
\end{equation}
\begin{equation} \label{eq:zwaartekracht}
F_{zwaartekracht}=m*g*sin(\theta)
\end{equation}
De bewegingsvergelijking wordt dus
\begin{equation}
F_{zwaartekracht} - F{rol}-F_{lucht}=m*\left(\frac{d^2x}{dt^2}\right)^2
\end{equation}
Deze vergelijking kan opgelost worden in functie van $Cd$.
\subsubsection{Feitelijke baan}
%Excel file praktische baan
Het tweede deel van het experiment bestaat uit het analyseren van de werkelijke baan van de wagen. Dit gebeurt met behulp van video-analyse. Terwijl het wagentje rijdt, wordt het door een camera gefilmd. Dit laat toe om achteraf de positie op bepaalde tijdstippen te bepalen. Deze afstand is af te lezen door een meetlat die naast de baan ligt. Met behulp van Excel worden al deze resultaten in een grafiek gezet. Ten slotte wordt op elk moment het verschil tussen de werkelijke afstand en de theoretische afstand genomen. Dit verschil wordt gekwadrateerd en al deze verschillen worden bij elkaar opgeteld. Deze som staat nog altijd in functie van de theoretische luchtweerstandsco\"effici\"ent $Cd$. Deze som wordt geminimaliseerd. De co\"effici\"ent die hierdoor verkregen wordt, is dan de werkelijke luchtweerstandsco\"effici\"ent. Deze blijkt volgens de numerieke uitwerking gelijk te zijn aan $180$.
\includepdf[pages={-}]{bijlagen/luchtweerstand/luchtweerstand-werkelijk.pdf}
