Michielvsb/po2-marsrover/bijlagen/elektrische-schakeling/sec.tex

\subsection{Elektrische schakeling}
\label{bijlage:elektrische-schakeling}
%\includepdf[pages={-}]{bijlagen/elektrische-schakeling/schakeling.pdf}
\begin{figure}[H]
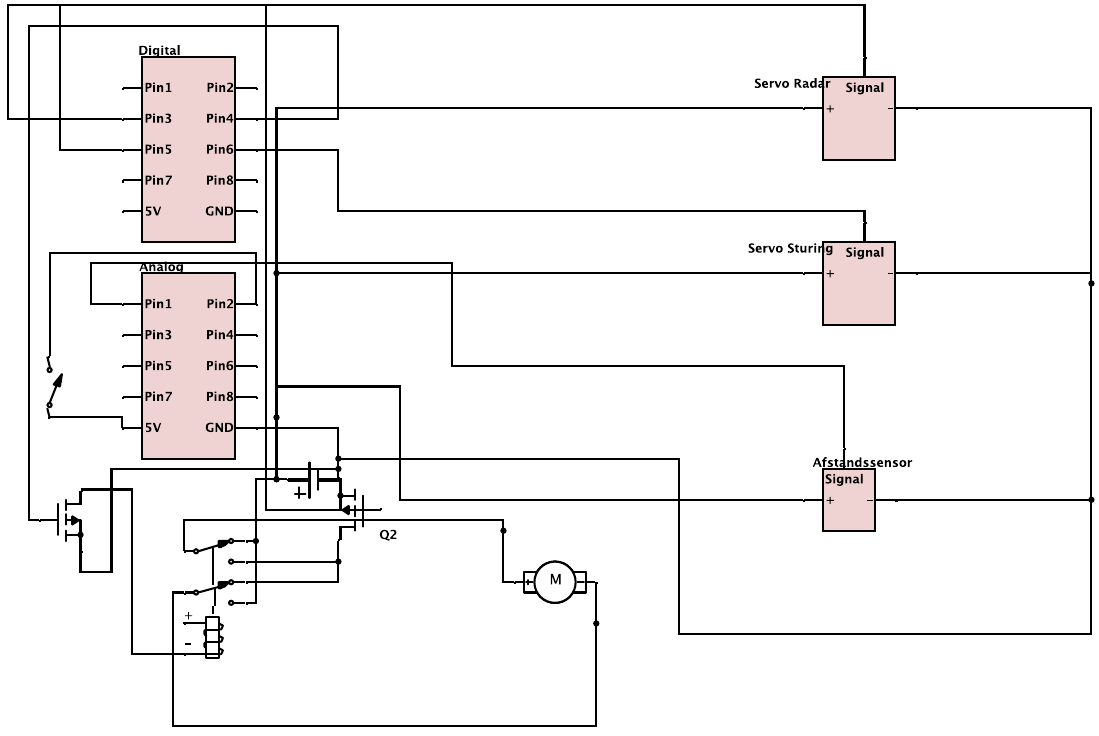
[picture p27: bijlagen/elektrische-schakeling/schakeling.png]

\caption{Elektrische schakeling}
\label{image:elektrische-schakeling}
\end{figure}
\FloatBarrier
