Michielvsb/po2-marsrover/bijlagen/technische-tekening/sec.tex

\subsection{Technische tekening}
\label{bijlage:technische-tekening}
\begin{figure}[H]
\center
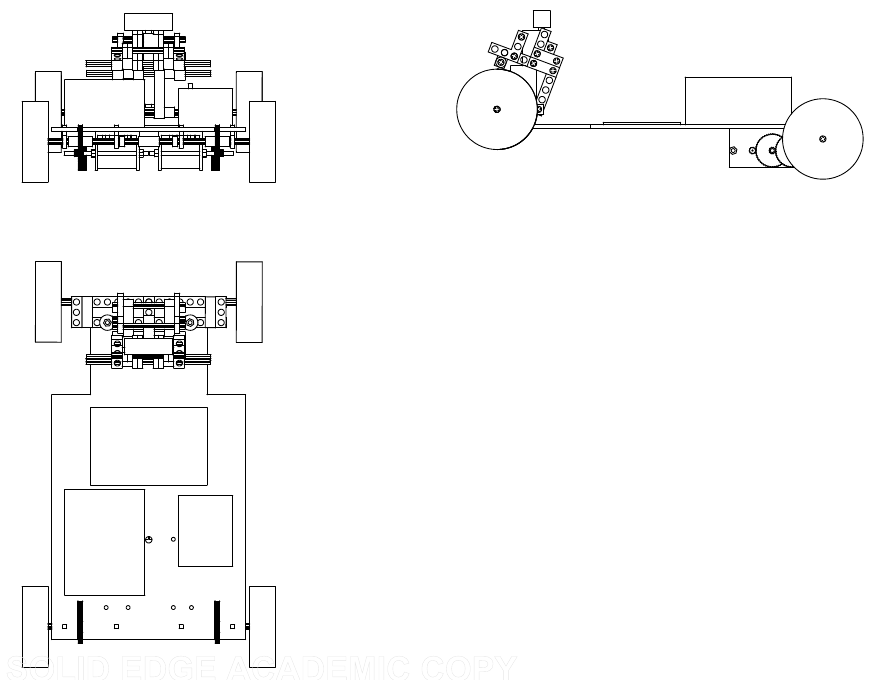
[picture p28: bijlagen/technische-tekening/wagen.png]
 
 \caption{Technische tekening van de wagen}
 \label{image:technische-tekening-wagen}
\end{figure}
\begin{figure}[H]
\center
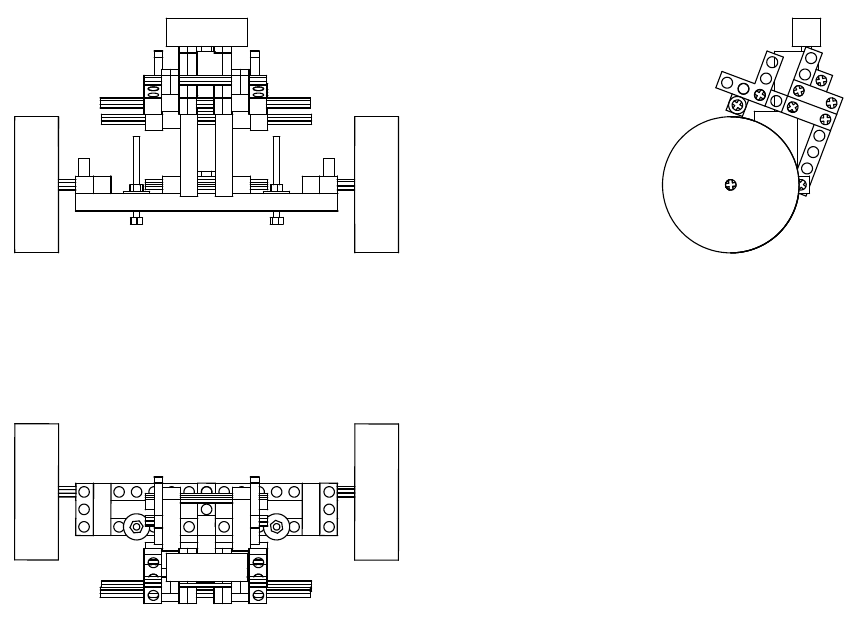
[picture p29: bijlagen/technische-tekening/stuur.png]
 
 \caption{Technische tekening van het stuur}
 \label{image:technische-tekening-stuur}
\end{figure}
\FloatBarrier
