Michielvsb/po2-marsrover/bijlagen/rolweerstand/rolweerstand.png

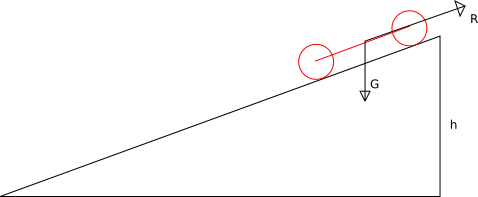
bijlagen/rolweerstand/rolweerstand.png
