Michielvsb/po2-marsrover/experimenten/sec.tex

 
\section{Experimenten}
\input{experimenten/rolweerstand/sec.tex}
\input{experimenten/luchtweerstand/sec.tex}
\input{experimenten/koppeloverdracht/sec.tex}
\input{experimenten/snelheidsmeting/sec.tex}
\input{experimenten/animatiefilmpje/sec.tex}
