Michielvsb/po2-marsrover/experimenten/animatiefilmpje/sec.tex

\subsection{Animatiefilmpje}

Een lineaire vergelijking bleek een erg goede benadering voor de bewegingsvergelijking van het wagentje (zie Bijlage~\ref{bijlage:animatiefilmpje}).
Het animatiefilmpje simuleert de beweging van het karretje dan ook alsof het een constante snelheid heeft gedurende het volledige parcours.

De Maplefile bevindt zich in Bijlage~\ref{bijlage:animatiefilmpje}. Met behulp van de voorgedefinieerde \verb|plot3d|-functies (\verb|polygonplot3d|), plot Maple het parcours en het wagentje in een opeenvolging van frames.
Verschillende zelfgedefinieerde procedures structureren het plotten van een frame door het onder te verdelen in enkele deeltaken. Zo zijn er de procedures \verb|plot_wagentje| en \verb|plot_wall_part| die voor een gegeven positie (en rotatie voor het wagentje), de nodige matrixbewerkingen uitvoeren en vervolgens het gevraagde object plotten.
Het parcours is gedefinieerd als een opeenvolging van punten. De muren en het wagentje worden opengetrokken op basis van hun coordinaten in het vlak. De bovenkant van de muren en het karretje zijn loodrechte translaties van het grondvlak. Telkens worden de overeenkomstige zijden als rechthoek geplot, zodat het model gesloten is.
De respectievelijke middens tussen de achterwielen en de voorwielen bevinden zich altijd op de lijn van het parcours. Met behulp van eenvoudige goniometrie wordt het karretje gedurende het rijden geroteerd zodat altijd aan deze voorwaarde voldaan is en de constante snelheid over de lijn behouden blijft. Deze vorm van rotatie is slechts een model en komt niet overeen met de bochten die het werkelijke ontwerp maakt.
De werkelijke rover stuurt enkel met de voorwielen en kan niet in rechte hoeken draaien, wat in het animatiefilmpje wel gebeurt.
