Michielvsb/po2-marsrover/bijlagen/technische-tekening/Tech_tek_stuur.pdf

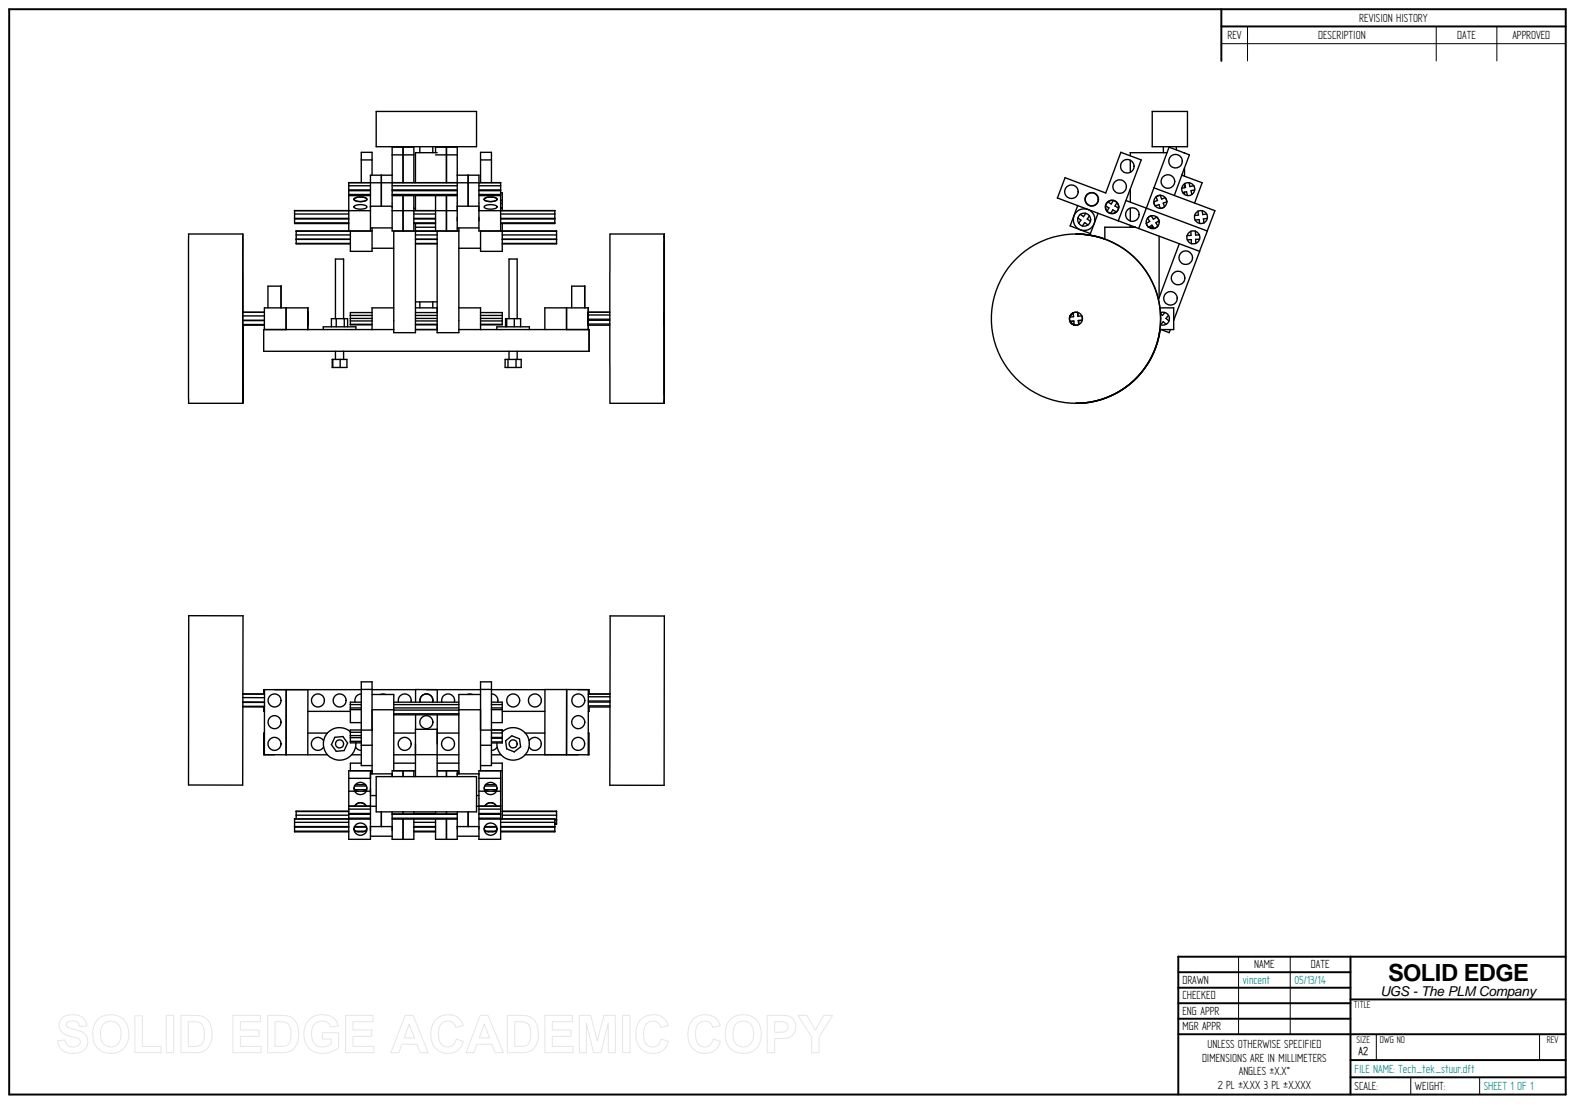
[picture p34: page 1]
TITLE; SCALE:; WEIGHT:; SHEET 1 OF 1

REVISION HISTORY

REV | DESCRIPTION | DATE | APPROVED

NAME | 05/13/14 DATE | SOLID EDGE UGS - The PLM Company

DRAWN | vincent
CHECKED
ENG APPR
MGR APPR
UNLESS OTHERWISE SPECIFIED DIMENSIONS ARE IN MILLIMETERS ANGLES ±X.X° 2 PL ±X.XX 3 PL ±X.XXX | SIZE A2 | DWG NO | REV

FILE NAME: Tech_tek_stuur.dft
