Michielvsb/po2-marsrover/bijlagen/overbrenging/optimale-overbrenging.pdf

## Optimale overbrengingsverhouding

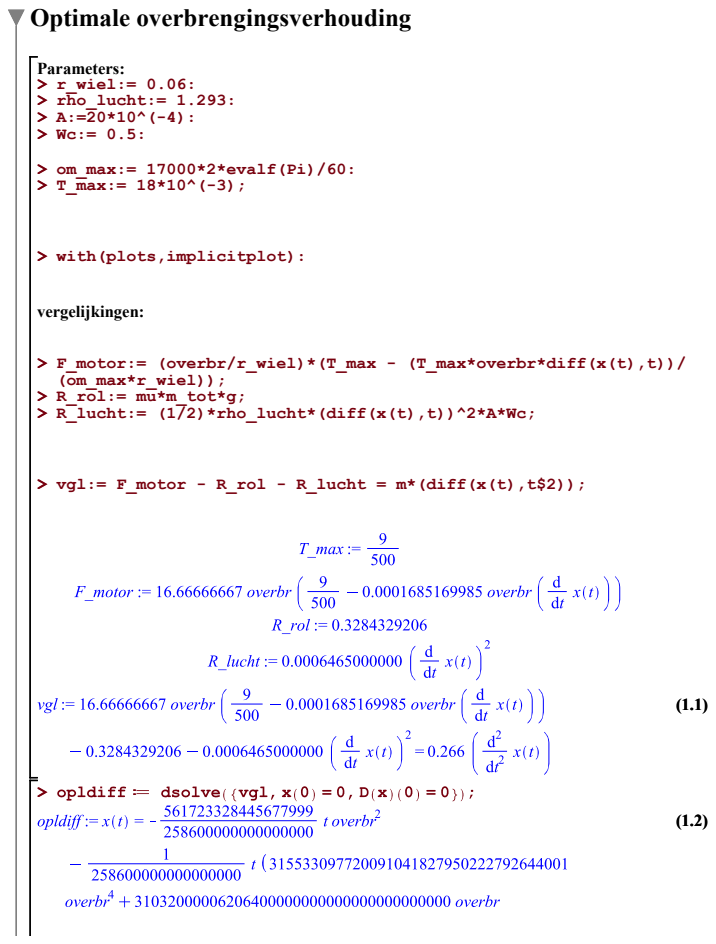
[picture p35: page 1]
Parameters: r_wiel:= 0.06: rho_lucht:= 1.293: A:=20*10^(-4): Wc:= 0.5:; om_max:= 17000*2*evalf(Pi)/60: T_max:= 18*10^(-3);; vergelijkingen:; F_motor:= (overbr/r_wiel)*(T_max - (T_max*overbr*diff(x(t),t))/ (om_max*r_wiel)); R_rol:= mu*m_tot*g; R_lucht:= (1/2)*rho_lucht*(diff(x(t),t))^2*A*Wc;; vgl:= F_motor - R_rol - R_lucht = m*(diff(x(t),t$2));

with(plots,implicitplot):

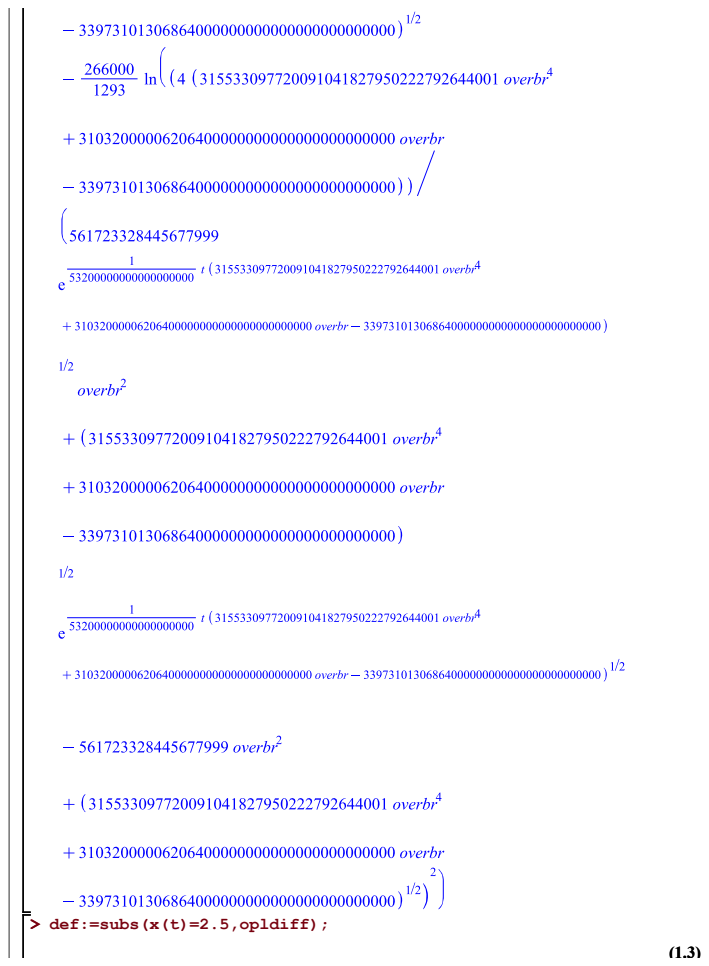
[picture p36: page 2]

def:=subs(x(t)=2.5,opldiff);

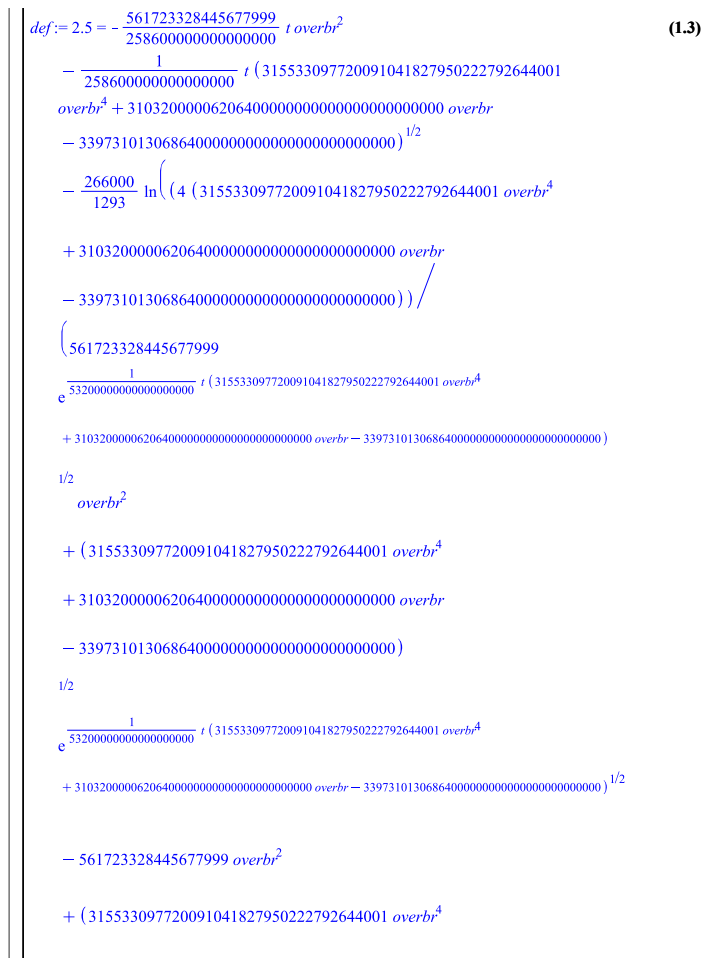
[picture p37: page 3]

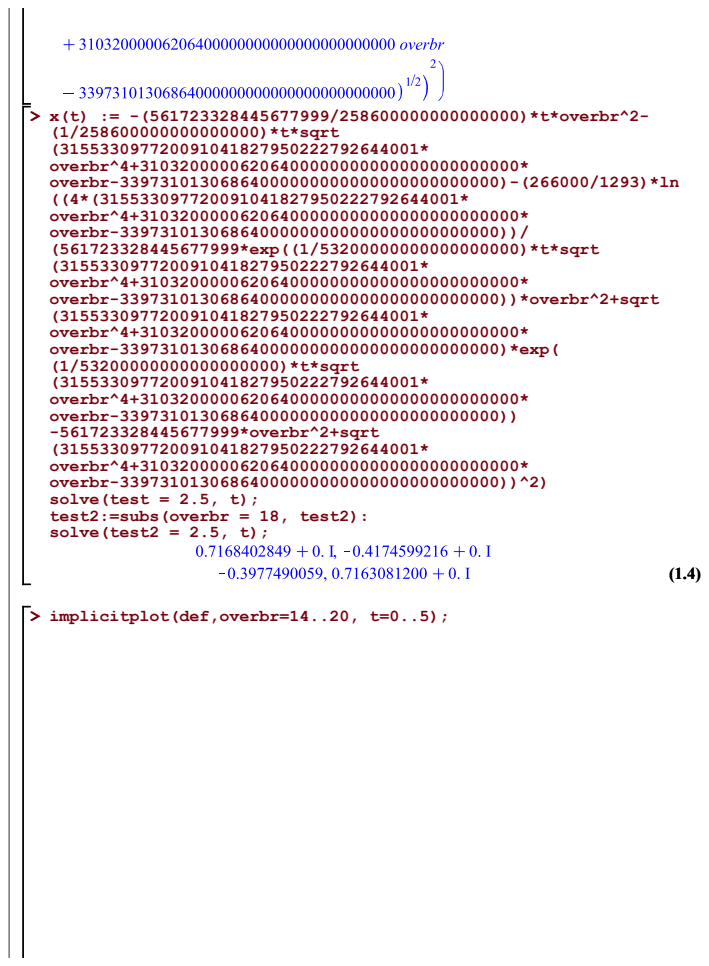
[picture p38: page 4]
x(t) := -(561723328445677999/258600000000000000)*t*overbr^2- (1/258600000000000000)*t*sqrt (315533097720091041827950222792644001* overbr^4+31032000006206400000000000000000000000* overbr-33973101306864000000000000000000000000)-(266000/1293)*ln ((4*(315533097720091041827950222792644001* overbr^4+31032000006206400000000000000000000000* overbr-33973101306864000000000000000000000000))/ (561723328445677999*exp((1/53200000000000000000)*t*sqrt (315533097720091041827950222792644001* overbr^4+3103200000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

implicitplot(def,overbr=14..20, t=0..5);

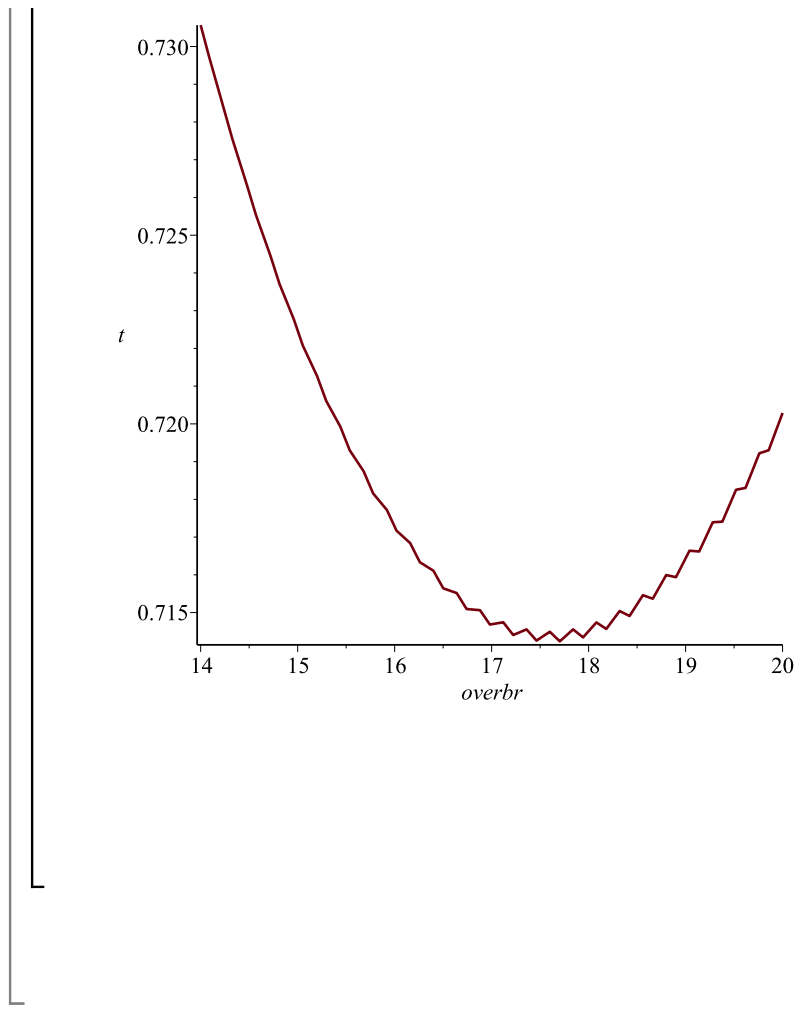
[picture p39: page 5]
