Michielvsb/po2-marsrover/bijlagen/technische-tekening/Tech_tek_wagen.pdf

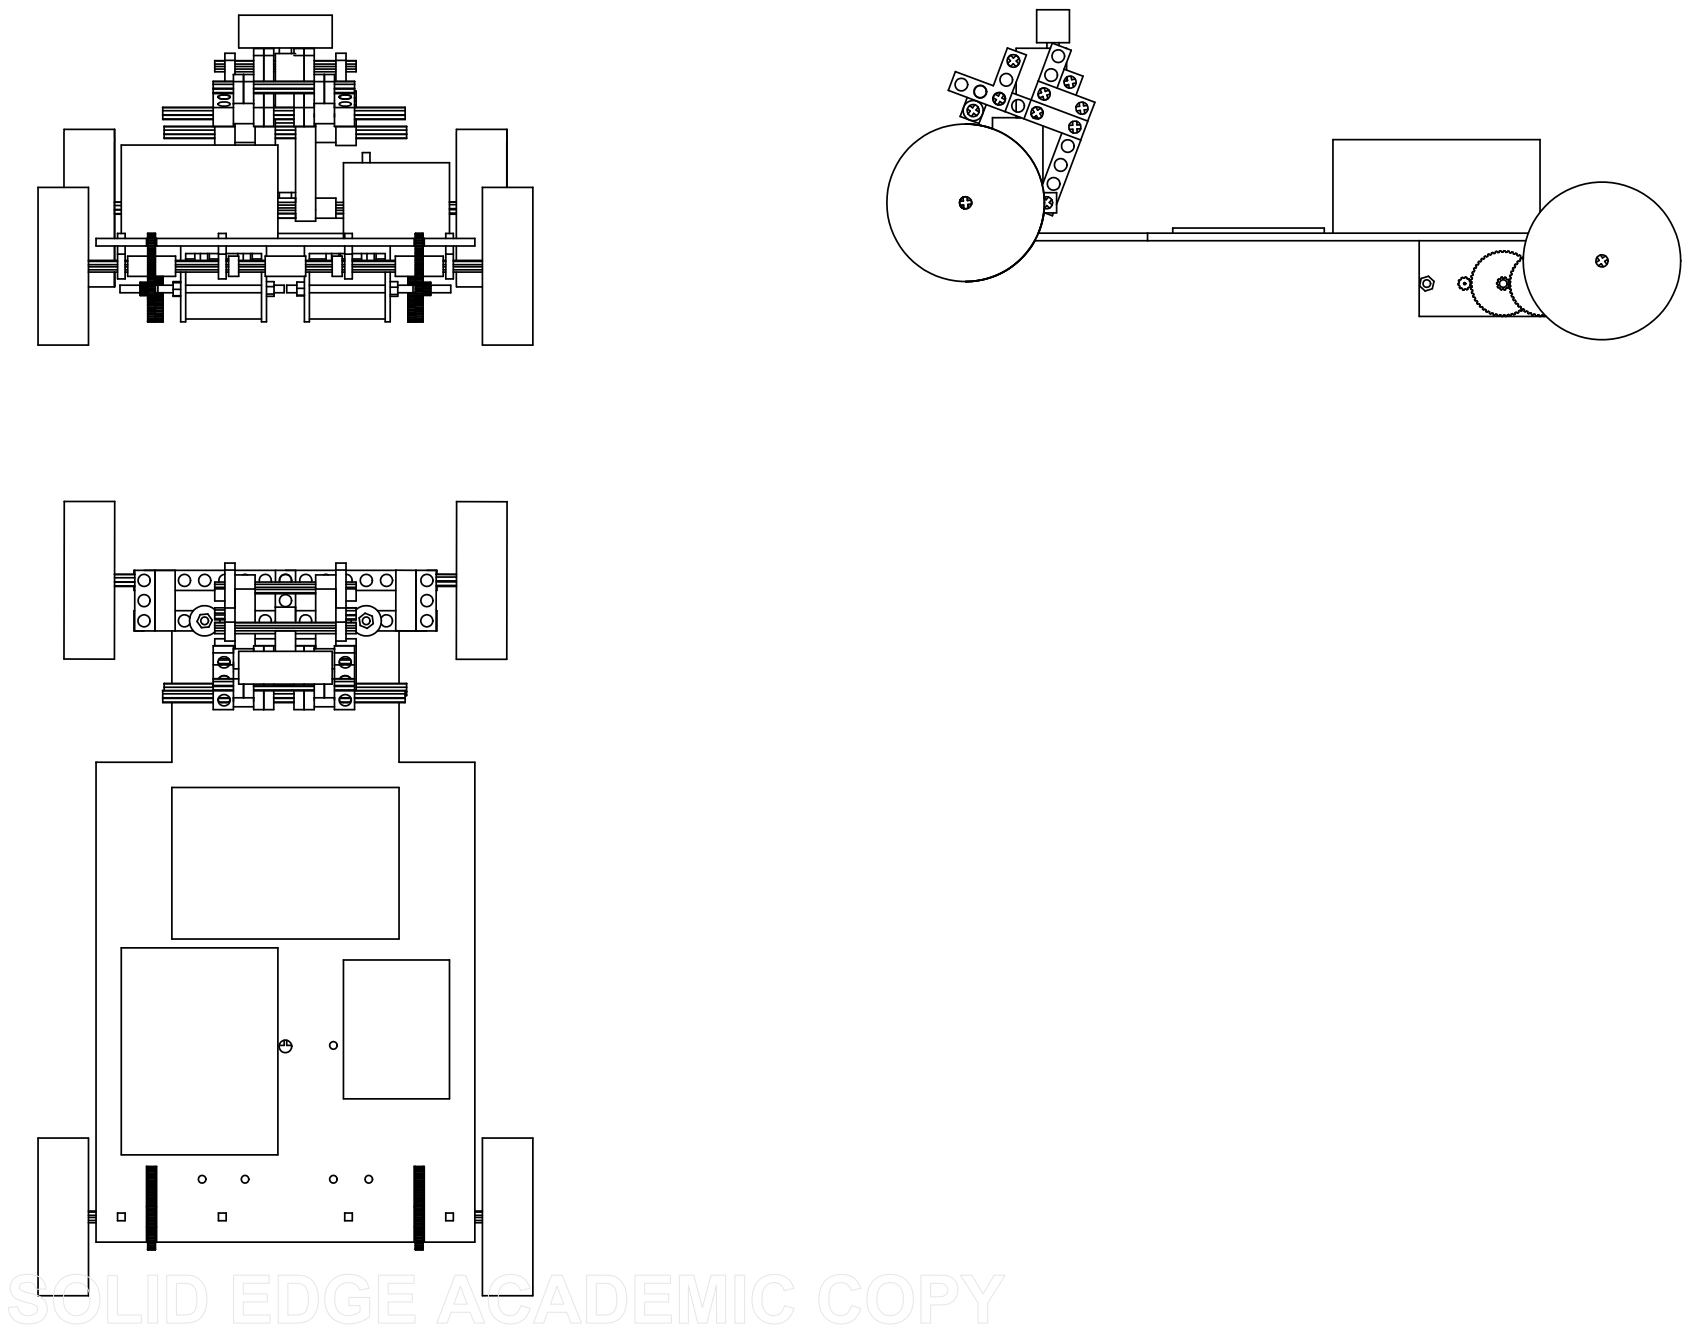
[picture p40: page 1]
