Michielvsb/po2-marsrover/bijlagen/elektrische-schakeling/schakeling.pdf

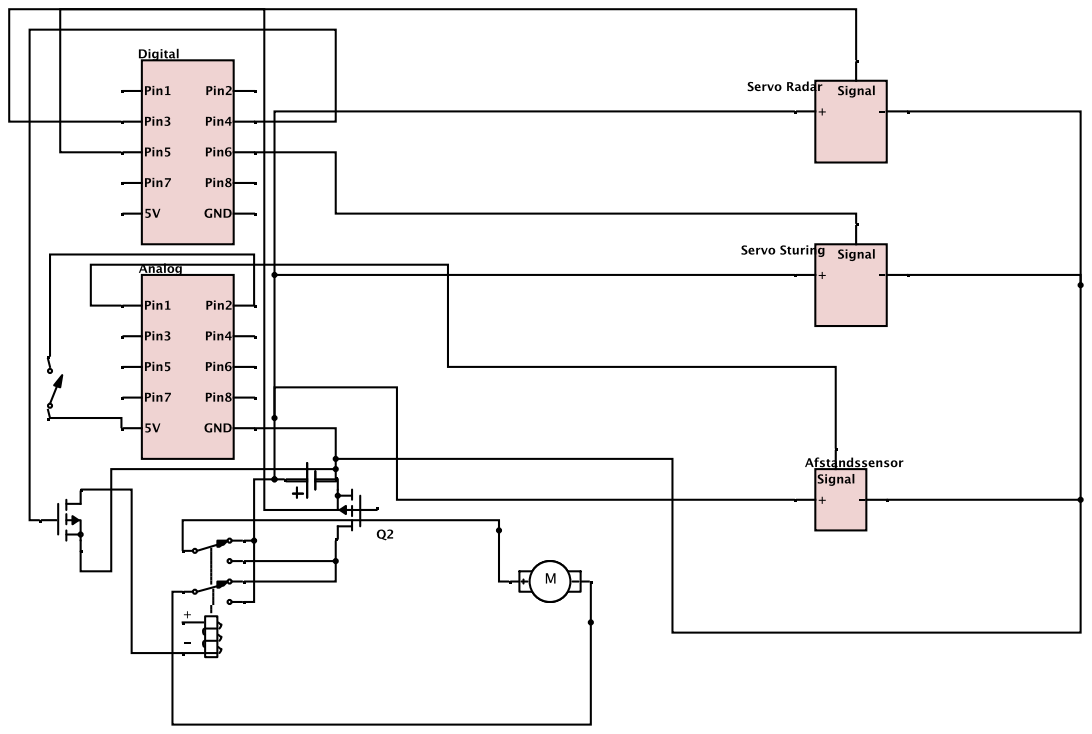
[picture p41: page 1]
