Michielvsb/po2-marsrover/bijlagen/animatiefilmpje/main.pdf

## Bewegingsvergelijking

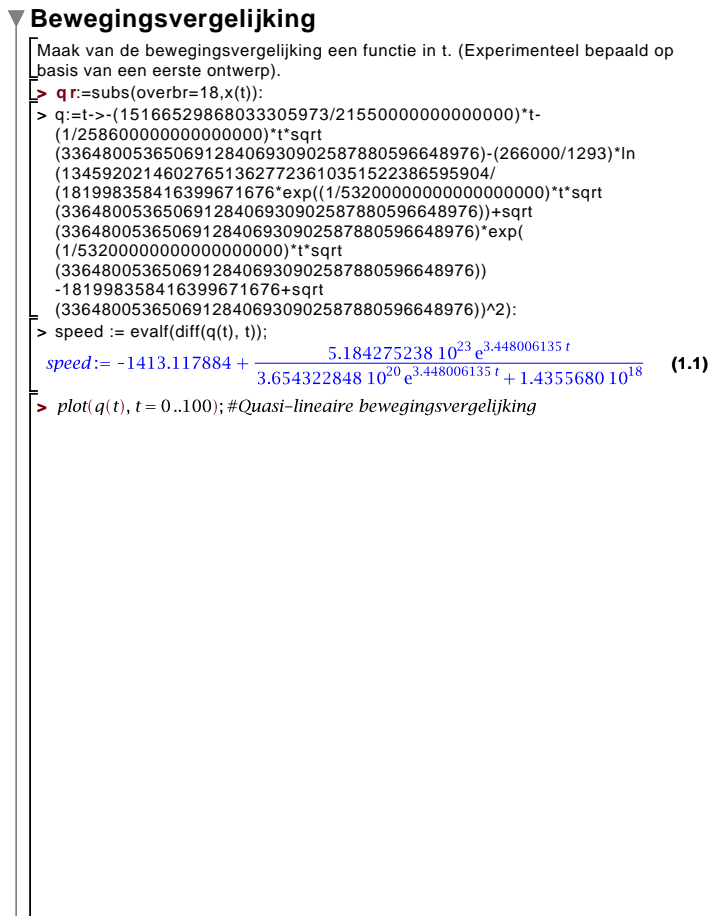
[picture p42: page 1]

Maak van de bewegingsvergelijking een functie in t. (Experimenteel bepaald op
basis van een eerste ontwerp).
(1/258600000000000000)*t*sqrt
(181998358416399671676*exp((1/53200000000000000000)*t*sqrt
(33648005365069128406930902587880596648976))+sqrt
(33648005365069128406930902587880596648976)*exp(
(1/53200000000000000000)*t*sqrt
-181998358416399671676+sqrt

qr:=subs(overbr=18,x(t)):

speed := evalf(diff(q(t), t));

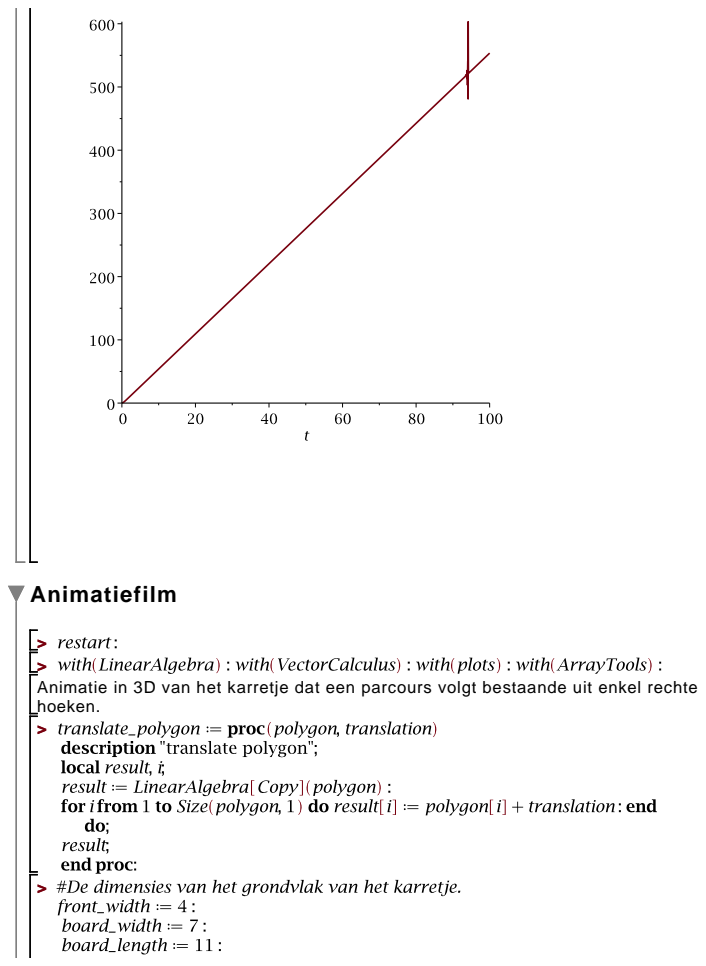
[picture p43: page 2]
Animatiefilm

Animatie in 3D van het karretje dat een parcours volgt bestaande uit enkel rechte
hoeken.

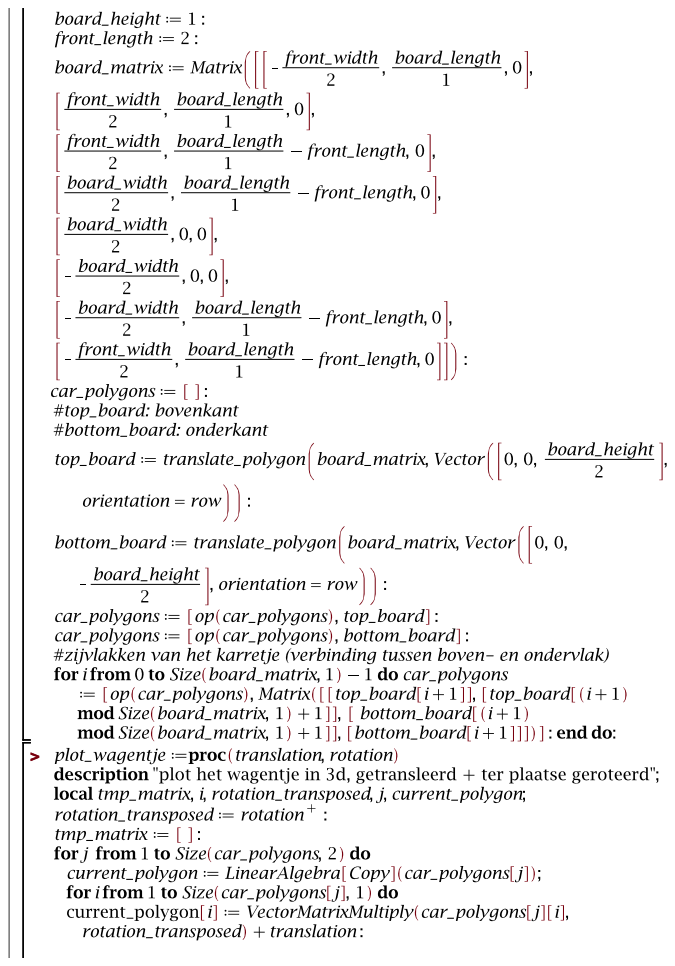
[picture p44: page 3]

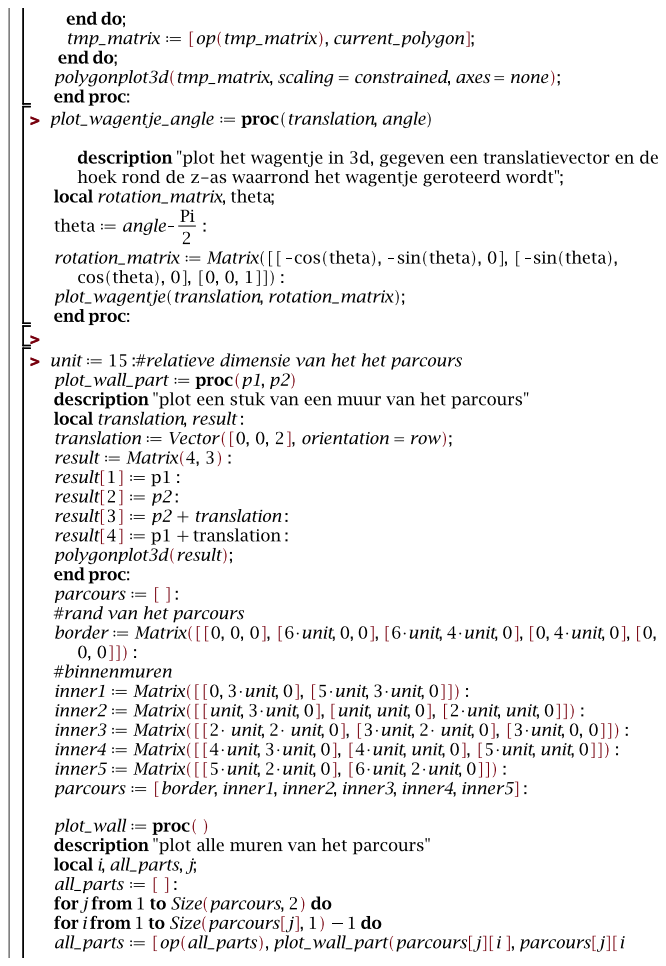
[picture p45: page 4]

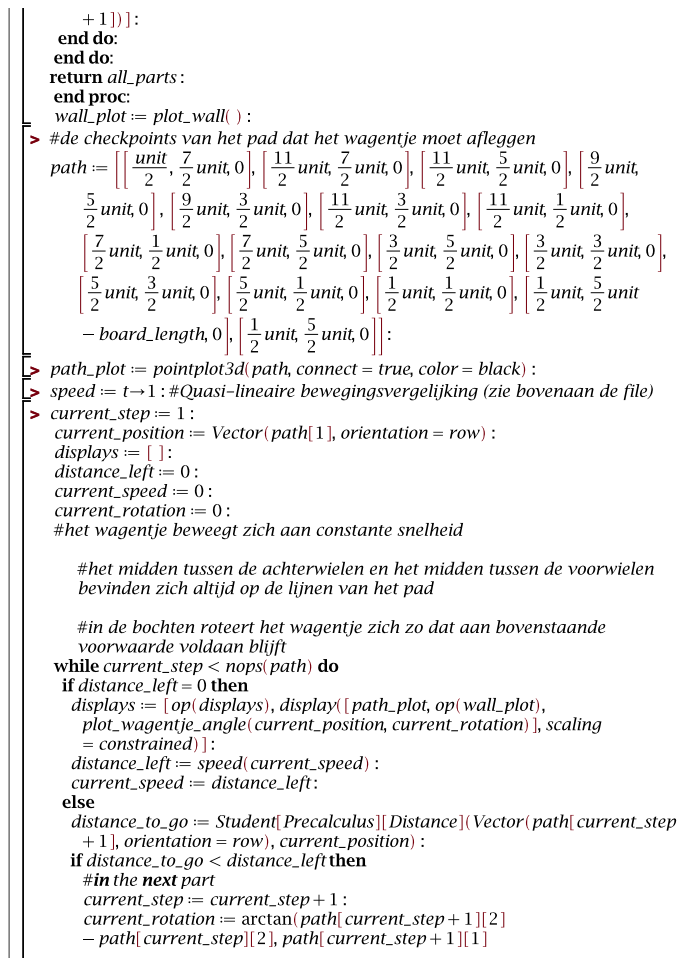
[picture p46: page 5]

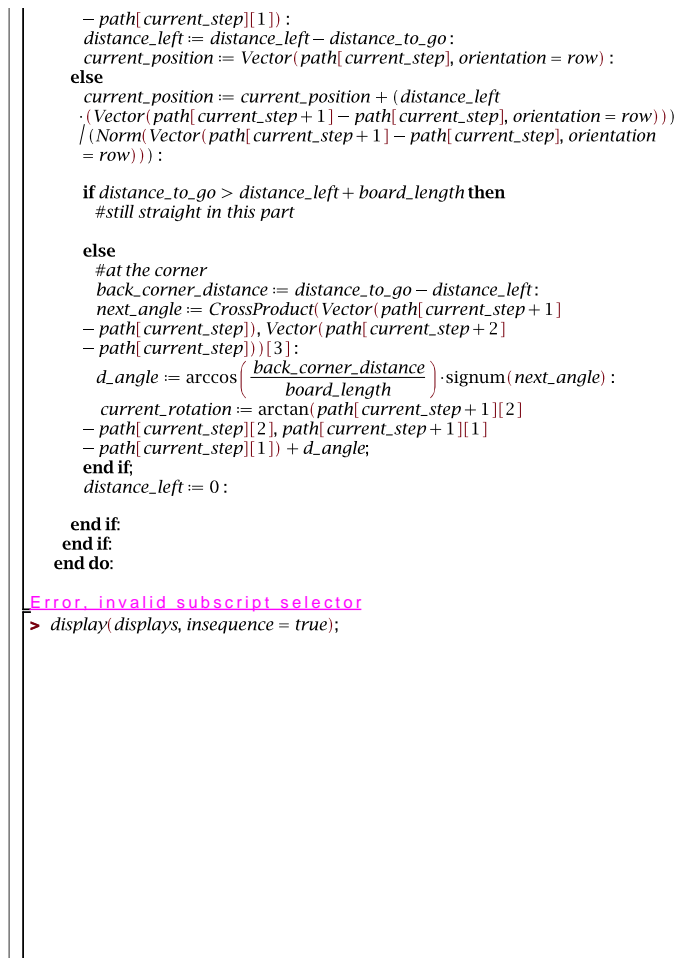
[picture p47: page 6]

Error, invalid subscript selector

>
