Michielvsb/po2-marsrover/(commit log)

2014-05-13 Materiaallijst+elektrische schakeling
    [Materiaallijst2.0 - Blad1.csv]
2014-05-13 LEGO Technic-onderdelen
    [lego_onderdelen_lijst - Blad1.csv]
2014-05-14 Update sec.tex
    stukje over de google wagens
